neuroandriyanov/PropValve-RE06MT/корпус/README.en.md

# Enclosure and blanking part

[Русский](README.md) | English

RUICHI A09 enclosure

Image of the **RUICHI A09** enclosure supplied by the author. The ribbed lid, screw fastening and mounting lugs are visible. The photograph was copied from the original directory without changes.

| File | Contents |
| --- | --- |
| `RUICHI A09.jpg` | Enclosure appearance |
| `заглушка.m3d` | Original blanking-part model |
| `заглушка.stl` | STL blanking-part model |
| `d.lxcf` | Accompanying file from the original package |

The board is located away from the valve's heat. According to the author's message of 31 October 2026, it operates on the machine, has passed testing, and no board heating has been observed.

## Photographs of the installed unit

- [Control enclosure installed on the machine](../фото/Корпус_на_машине.jpg).
- [Control board inside the enclosure, lid open](../фото/Плата_в_корпусе.jpg).

The author added these photographs on 2 November 2026, and their bytes were preserved. The open-enclosure photograph shows the board layout and connected wires. Enclosure dimensions and ingress-protection rating were not determined from photographs.
