neuroandriyanov/PropValve-RE06MT/схема_плата/README.md

# Аппаратная часть

[Русский](README.md) | [English](README.en.md)

- `схема.pdf` — два листа: питание, силовой/аналоговый тракт; затем DSP, EEPROM и интерфейс.
- `Proportional Valve Controller_v0/` — распакованный набор Gerber/сверловки: 7 файлов `.gbr`, `Through1.drl` и `Through2.tap`.
- `Спецификация_для_пайк.xlsx` — историческая ведомость пайки, номиналы и оценки стоимости. Это не актуальная смета закупки.

Файлы DipTrace `.dip`/`.dch`, библиотеки и ZIP-дубликат Gerber исключены автором из пакета. Для просмотра оставшихся материалов нужны PDF- и Gerber-просмотрщики.

Плата автора уже установлена на машине и прошла испытания; нагрев платы при работе не наблюдается. Следующие замечания относятся к воспроизведению по приложенным материалам.

## Разъёмы данной платы по PDF

| Разъём | Назначение | Примечание |
| --- | --- | --- |
| X1 | Питание 24 В | Контакт 1: +24 В, контакт 2: GND |
| X2 | Катушка | Подключение силового выхода проверять по схеме и своей нагрузке |
| X3 | Выход контроля фактического тока | Контакт 1: сигнал, контакт 2: GND_ISO |
| X4 | Внешнее задание 0–10 В | Контакт 1: сигнал, контакт 2: GND_ISO |
| X5 | Интерфейс программирования | Сверить обе стороны подключения по второму листу схемы |

`GND` и `GND_ISO` — разные обозначенные цепи. Нумерация X1…X5 относится к этой PCB; она не совпадает с обозначениями A…G штатного разъёма Parker. Прямой кабель-переходник и его распиновка в материалах не подтверждены.

## Что учесть при воспроизведении

Для приложенных калибровок **R42 и R43 = 10 кОм**. PDF уже обновлён, но BOM содержит 180 Ом и фото отражает старые номиналы. R3 в той же строке спецификации остаётся отдельным элементом: указание замены относится только к R42/R43.

У DA7.2 в PDF сохранена авторская пометка «ошибка». Фото показывает проводную доработку возле DA7. При воспроизведении следует учитывать эту доработку. PDF и Gerber оставлены без редактирования; отдельного исправленного набора производственных файлов в ходе подготовки пакета не создавалось.

В [папке корпуса](../корпус/README.md) сохранены `заглушка.m3d`, `заглушка.stl`, `d.lxcf` и добавленное автором изображение `RUICHI A09.jpg`.
