neuroandriyanov/PropValve-RE06MT/docs/ENGLISH-UPDATE.md

# English documentation update — 7 November 2026

Package revision 5 adds English companions for the complete authored documentation, the three historical calibration reports, the multimeter protocol guide and the historical handoff. Root and current-directory Markdown documents receive language navigation; Russian technical prose is retained. The Mermaid block diagram has an English version in README.en.md. Shared photographs, all DSP projects, coefficient tables, JSON/JSONL measurements, hardware files, manufacturer PDF and original historical TXT files remain byte-identical.

The schematic's two Russian annotations are translated in `схема_плата/ANNOTATIONS.en.md`. The [English BOM workbook](../схема_плата/Спецификация_для_пайк.en.xlsx) translates 196 text cells across all three worksheets, sheet names, and printed headers and footers. All 416 numerical cells (including formula caches), 238 formulas, component designators, source links, formatting and print settings are preserved; formula and named-range references are updated to the English sheet names. The original XLSX remains byte-identical. Every translated cell label and explanatory note is also documented with its original cell address in `схема_плата/BOM-labels.en.md`. Manufacturer documentation is already English. Hardware connections and ratings are not inferred from labels or photographs.

The workbook was edited and recalculated with the spreadsheet authoring tool. Its export did not preserve existing print settings, so the translated text was transferred into the original XLSX package with only text and sheet-reference substitutions. Unaffected ZIP members were checked byte-for-byte; all three translated sheets were rendered and reviewed, and formula-error scans returned no matches.

The exact previous package manifest is retained at `docs/manifests/pre-english-2026-11-07.json`. Before refreshing the current manifest, its tracked-file hashes were compared: only deliberate Markdown language-navigation edits were permitted. Added translation material and workflow files are included in revision 5. Historical measurement data are not regenerated. The old manifest remains a record of revision 4 and is not updated to make its files appear unchanged.

`translations.json` records hashes of both source and reviewed translation. `tools/translations.mjs status` reports missing or stale translations without preventing Russian-first publication; `status --strict` can be used when checking a completed translation set. Workflow instructions are in `docs/TRANSLATIONS.md` and `docs/TRANSLATIONS.en.md`.

Verification for this update concerns translation links, numerical transcription, package integrity and saved DSP tables. It is not a new compilation, EEPROM write, or hardware test.
