neuroandriyanov/PropValve-RE06MT/проект_сигма/Калибровка_входа_0_10В_2026-10-27.en.md

# 0–10 V input calibration, ADC0 — 27 October 2026

[Русский, original TXT](Калибровка_входа_0_10В_2026-10-27.txt) | English

Historical report translated without changing its values. This temporary X3–X4 calibration connection must not be retained in the final control path; see the [current setup instructions](../docs/SETUP.en.md).

The user fitted an X3–X4 jumper and replaced R42 with 10 kΩ. Calibration used the connected multimeter in DC V mode. The source was the previously calibrated X3 output; measurements were made directly at the connected X3/X4. Eleven points were checked, including intermediate points and a repeated zero.

Working project: `Design1_parker_v0.dspproj`. Complete reference copy: `Design1_parker_io_calibrated.dspproj`. The project was loaded into RAM; EEPROM was not written.

## Input path

`Input1, ADC0 -> VIN_LPF_20Hz -> VIN_TABLE_0_10V -> VIN_LIMIT_MIN -> VIN_LIMIT_MAX -> VIN_MEAS_0_1`.

LPF: first order, 20 Hz, gain 0 dB. At Fs=96 kHz, the time constant is approximately 8 ms; settling to 1% after a step takes approximately 37 ms. `VIN_MEAS_0_1` is the normalized input: voltage in volts = reading * 10. `ADC0_RAW` is unsmoothed ADC0; `VIN_FILTERED` is smoothed ADC0 before normalization. The coil had a zero command during calibration. No connection from `VIN_MEAS_0_1` to the current command was added.

Table Min=-1, Max=+1. This is the ADC0 data range, not the voltage at X4. Over the working 0..10 V range, ADC0 varied approximately -0.02050..+0.74948. No saturation was found. The full table range was retained for margin; its output is separately limited to 0..1 by two conditional blocks. `VIN_ZERO=0`, `VIN_ONE=1`, `VIN_LIMIT_MIN` condition: `>`, `VIN_LIMIT_MAX`: `<`. Negative and greater-than-1 coefficients at the outer table knots are extrapolation and are valid. The final signal is limited to 0..1.

## Coefficients at ADC0 knots -1; -0.5; 0; +0.5; +1

```text
-1.00 -> -1.279143881855
-0.50 -> -0.626184519830
0.00 -> 0.026774842194
0.50 -> 0.676254106065
1.00 -> 1.325107241990
```

## Last independent verification

| Multimeter, V | DSP normalized | Equivalent, V | Difference, mV |
| --- | --- | --- | --- |
| 0.0000 | 0.00000536 | 0.00005 | +0.054 |
| 1.0000 | 0.10006195 | 1.00062 | +0.620 |
| 1.2490 | 0.12503260 | 1.25033 | +1.326 |
| 2.5000 | 0.24994069 | 2.49941 | -0.593 |
| 3.7500 | 0.37491131 | 3.74911 | -0.887 |
| 4.9990 | 0.49981421 | 4.99814 | -0.858 |
| 6.2500 | 0.62501651 | 6.25017 | +0.165 |
| 7.5000 | 0.75012231 | 7.50122 | +1.223 |
| 8.7500 | 0.87510180 | 8.75102 | +1.018 |
| 10.0000 | 0.99988711 | 9.99887 | -1.129 |
| 0.0000 | 0.00000954 | 0.00010 | +0.095 |

Maximum observed difference from the multimeter reading: 1.326 mV. This is a difference between readings in this series, not an estimate of the entire system's absolute error: it also depends on the multimeter's accuracy and resolution.

The earlier 0..10 V output, 0..3 A command and current-measurement tables were compared with the backup before work: their coefficients and ranges were unchanged. The voltage output and current command were returned to zero at the end.

## Files

- `voltage_input_0_10V.txt` — coefficients for loading the table.
- `voltage_input_settings.json` — range, filter, limits and other settings.
- Historical `output/meter/voltage_input_raw.json` — initial ADC0 check.
- Historical `output/meter/voltage_input_filtered.json` — calibration points after the LPF.
- Historical `output/meter/voltage_input_verify.json` — independent normalized-input verification.

The historical `output/meter/` records are now in `measurements/2026-10-27/`.

Before future batch DSP reads, disable continuous controls (Action → Disable All Continuous ReadBack Controls, Ctrl+F12). After API compilation, bind new readbacks using the native Action → Link Compile Download (F7), then Ctrl+F11. Do not rerun the one-off build/connect/fit_voltage_input.py scripts.
