neuroandriyanov/PropValve-RE06MT/проект_сигма/Калибровка_тока_2026-10-27.en.md

# Current and feedback calibration — 27 October 2026

[Русский, original TXT](Калибровка_тока_2026-10-27.txt) | English

Historical report translated without changing its values. Manual sources mentioned here were removed later; see the [current status](../docs/STATUS.en.md).

The user replaced R43: 180 Ω → 10 kΩ. Working project: `Design1_parker_v0.dspproj`. Reference copy: `Design1_parker_current_calibrated.dspproj`. Fs=96 kHz. The project was loaded into RAM. EEPROM was not written.

`CURRENT_INPUT_0_1` is the 0..1 command input in 5.23 format. `CURRENT_0_3A` is the current-command table, input range 0..1. `ZERO_OFF` makes both DAC0/DAC1 digital commands zero for a command <=0. With a positive command, DAC0=table(x), DAC1=-table(x). `ZERO_CONSTANT` must remain zero.

## Measurement path

`ADC1 -> CURRENT_LPF_20Hz -> FB_LIMIT_MIN -> FB_LIMIT_MAX -> I_FEEDBACK_0_1 -> I_MEAS_0_1`.

`CURRENT_LPF_20Hz` is a first-order 20 Hz low-pass filter with 0 dB gain. `I_FEEDBACK_0_1` is a five-point interpolator: Min=-0.78, Max=0.70. `FB_LIMIT_MIN/MAX` explicitly limit the interpolator input to -0.78..0.70. `FB_MIN_CONST=-0.78` and `FB_MAX_CONST=0.70` must match Min/Max.

`I_MEAS_0_1` is normalized measured current; amperes = value * 3. `ADC1_RAW` is the unsmoothed diagnostic ADC1 signal. No digital regulation loop was closed through `I_MEAS_0_1`; the TL494 analog current controller continued to control the power stage.

## Command coefficients

```text
0.00 -> 0.023218750000
0.25 -> 0.159650674870
0.50 -> 0.290056819700
0.75 -> 0.418537411283
1.00 -> 0.546914277550
```

## Measurement coefficients at evenly spaced knots from -0.78 to +0.70

```text
-0.780 -> 0.000000000000
-0.410 -> 0.245772526859
-0.040 -> 0.493489060467
0.330 -> 0.742258512976
0.700 -> 1.000000000000
```

## Independent multimeter verification

| Input | Target, A | Multimeter, A | DSP normalized | DSP equivalent, A |
| --- | --- | --- | --- | --- |
| 0.000 | 0.000 | 0.0000 | 0.000940 | 0.0028 |
| 0.125 | 0.375 | 0.3675 | 0.123211 | 0.3696 |
| 0.250 | 0.750 | 0.7475 | 0.249255 | 0.7478 |
| 0.500 | 1.500 | 1.4995 | 0.499490 | 1.4985 |
| 0.750 | 2.250 | 2.2510 | 0.750680 | 2.2520 |
| 1.000 | 3.000 | 2.9980 | 0.999998 | 3.0000 |
| 0.000 | 0.000 | 0.0000 | 0.000000 | 0.0000 |

After R43 was replaced, no ADC1 saturation was found over 0..3 A: at approximately 3 A, the unsmoothed signal was approximately +0.658 to +0.754. Smoothing reduces reading spread but does not eliminate zero drift. In one calibration series, zero shifted by approximately 0.013 ADC units, equivalent to approximately 26 mA. A fixed table does not compensate for zero changes between series.

This verification describes the board during the measurements, not guaranteed temperature accuracy after cooling/warming. The interpolator itself does not correctly limit values outside Min/Max: before `FB_LIMIT_MIN/MAX` were added, that caused incorrect readings at the ends. Separate blocks now limit the input before the interpolator. Apply `CURRENT_INPUT_0_1` only within its stated 0..1 range.

Full records: historical path `output/meter/feedback_*.json` (now under `measurements/2026-10-27/`). `current_command_0_3A.txt` and `current_feedback_0_3A.txt` contain coefficients only. Min/Max are saved in the project and JSON. DAC3 0..10 V voltage calibration was checked; coefficients were unchanged. At the end, the command was set to zero. Do not rerun the one-off `install_*.py` and `refine_feedback.py` scripts.
