neuroandriyanov/PropValve-RE06MT/корпус/README.md

# Корпус и заглушка

[Русский](README.md) | [English](README.en.md)

Корпус RUICHI A09

Изображение корпуса **RUICHI A09**, добавленное автором. Видны ребристая крышка, винтовое крепление и монтажные проушины. Фото скопировано из исходной папки без изменений.

| Файл | Содержимое |
| --- | --- |
| `RUICHI A09.jpg` | Внешний вид корпуса |
| `заглушка.m3d` | Исходная модель заглушки |
| `заглушка.stl` | STL-модель заглушки |
| `d.lxcf` | Сопутствующий файл исходного комплекта |

Плата вынесена из зоны нагрева клапана. По сообщению автора от 31.10.2026 она работает на машине, прошла испытания, нагрев платы не наблюдается.

## Фотографии установленного блока

- [Корпус блока управления, установленный на машине](../фото/Корпус_на_машине.jpg).
- [Плата управления в корпусе — вид при открытой крышке](../фото/Плата_в_корпусе.jpg).

Фотографии добавлены автором 02.11.2026 и сохранены без изменения байтов. На снимке открытого корпуса видны размещение платы и подключённые провода. Размеры и степень защиты корпуса по фотографиям не определялись.
