neuroandriyanov/PropValve-RE06MT/docs/STATUS.md

# Состояние проекта и результаты проверки материалов

[Русский](STATUS.md) | [English](STATUS.en.md)

Состояние сохранённых калибровок: 27.10.2026. Уточнение автора и повторный обзор пакета: 31.10.2026.

## Работа на машине

Автор сообщил 31.10.2026: **плата уже установлена и работает на машине, испытания пройдены, нагрев платы не наблюдается**. Вынос электроники из зоны нагрева клапана выполнен и проверен в эксплуатации данного экземпляра.

Прежняя запись о том, что объединённая цепь ещё не испытана, описывала состояние журнала калибровки от 27.10.2026. Для текущего эксплуатационного статуса она устарела. Указанная дата — дата сообщения автора, а не установленная дата проведения испытаний. Численные температуры, длительность и режимы испытаний не сообщались.

## Рабочая версия

`проект_сигма/Design1_parker_v0.dspproj` и `Design1_parker_transfer_2026-10-27.dspproj` побайтово совпали при подготовке. Файл разобран data-only NRBF-парсером: в нём четыре таблицы, нужные константы и индикаторы; старых ручных источников `CURRENT_INPUT_0_1` и `DC2_4` нет. Соединения сохранённого netlist соответствуют цепям, приведённым в README.

Отчёт сохранённого компилятора: 153 инструкции, 38 слов Data RAM, 45 слов Parameter RAM. Сам отчёт содержит общий текст об оценке для 48 кГц; используемая частота проекта 96 кГц зафиксирована в настройках калибровки и журнале. Не трактуйте строку шаблона отчёта как подтверждение текущей частоты аппаратуры.

При подготовке документов ассистент проверяет файлы без подключения к оборудованию. Испытания на машине проведены автором; повторный запуск машины в рамках обзора папки не выполнялся. Рабочий `.dspproj` в пакете не изменялся.

## Калибровки

Ниже — максимальные наблюдавшиеся разности в сохранённых сериях, а не гарантированная абсолютная точность или допуск для другого экземпляра платы.

| Канал | Наблюдение | Протокол в `measurements/2026-10-27/` |
| --- | --- | --- |
| Выход 0–10 В | До 1 мВ относительно показания прибора | `output_calibration_verification.json` |
| Задание тока | До 7.5 мА между заданием и показанием прибора | `feedback_final_verification.json` |
| Измерение тока DSP | Около 2.8 мА относительно прибора в итоговой серии | `feedback_final_verification.json` |
| Вход 0–10 В | До 1.326 мВ, проверка в 11 точках | `voltage_input_verify.json` |

Эти сохранённые серии относятся к калибровке отдельных каналов **до окончательного объединения цепи**. После этого автор подтвердил успешные испытания платы на машине. Точность приведённых серий ограничивается в том числе точностью и разрешением мультиметра. В одной старой серии отмечен дрейф нуля измерения тока примерно на 26 мА в эквиваленте. Это наблюдение калибровочного этапа, а не результат нового измерения на машине.

Точные коэффициенты и Min/Max извлекаются командой `py -3 tools/sigma/inspect_project.py`. Внешние TXT-файлы коэффициентов не содержат всей настройки блока. Сохранённый `.dspproj` и JSON-настройки предпочтительнее для восстановления.

| Таблица | Входной диапазон | Роль |
| --- | --- | --- |
| `VIN_TABLE_0_10V` | −1…+1 | ADC0 → нормированное напряжение; выход дополнительно ограничен 0…1 |
| `CURRENT_0_3A` | 0…1 | Задание → код дифференциального выхода DAC0/DAC1 |
| `I_FEEDBACK_0_1` | −0.78…+0.70 | ADC1 → нормированный фактический ток; перед таблицей стоят ограничители |
| `Interpolator1` | 0…1 | Нормированный ток → DAC3 → X3; DAC2 должен быть 0 |

## Различия между материалами

1. **R42/R43.** В текущем PDF уже 10 кОм. В исходной спецификации XLSX — 180 Ом, на фото видна маркировка `1800`. Рабочие калибровки относятся к 10 кОм. Фото и BOM оставлены без правок как исходные материалы; их нельзя безусловно использовать для сборки откалиброванной версии.
2. **DA7.2.** На первом листе схемы есть пометка «ошибка» у буфера refdac. Возле DA7 на фото видна проводная доработка. Документированного соответствия этой доработки конкретной PCB-ревизии нет. Схему исправления по одному фото не восстанавливали.
3. **Состав аппаратных файлов.** По решению автора `.dip`, `.dch`, библиотеки DipTrace и ZIP-дубликат удалены из пакета. Сохранены PDF, распакованный набор Gerber/сверловки v0 и XLSX. Для нового изготовления учитывайте номиналы и доработку, описанные выше.
4. **Распиновка и диапазоны.** Маркировка платы на фото упоминает ±10 В; сохранённый DSP-проект откалиброван на 0…10 В. Не расширяйте рабочий диапазон только по надписи на PCB.
5. **Паспорт Parker.** В приложенном документе есть исполнения F (0…10 В в таблице и блок-схеме) и R (4…20 мА). На вводной странице также встречается ±10 В. Это не подтверждает поддержку всех вариантов данной платой. Точный заказной код модернизированного экземпляра отсутствует.
6. **Ток.** В паспорте штатного клапана указан максимальный потребляемый ток 2.0 А. Это не равно утверждённому пределу тока катушки. Шкала стендовой платы 3 А требует отдельного сопоставления с конкретным соленоидом; универсальная совместимость не установлена.
7. **EEPROM.** E2Prom.bin/Hex в `archive/eeprom-unverified/` относятся к исходному архиву. Журнал от 27.10.2026 отмечал отсутствие записи на том этапе. Сведения о текущем содержимом EEPROM работающей машины отдельно не передавались; архивные образы не объявляются её проверенной копией.

## Воспроизведение на другом экземпляре

Для нового экземпляра уточняют исполнение клапана и параметры катушки, сверяют PDF/BOM/Gerber и доработку DA7.2, затем проводят собственную калибровку. Порядок подключения и проверки перемычки X3–X4 приведён в [SETUP.md](SETUP.md). Это порядок переноса на другое оборудование, а не перечень непроведённых испытаний авторской машины.

В сохранённом DSP-проекте `ZERO_OFF` сравнивает задание с точным нулём. Обсуждавшийся ранее гистерезис 10/20 мВ в этом файле не реализован. Это возможное развитие проекта, а не установленный недостаток работы машины. `ZERO_CONSTANT` питает и порог, и нулевой выход; изменять его без разделения этих функций нельзя.

## Корпус и обновление комплекта

Добавлено [изображение RUICHI A09](../корпус/RUICHI%20A09.jpg), найденное в исходной папке `корпус/`. Оно показывает внешний вид корпуса с ребристой крышкой и монтажными проушинами. Файлы заглушки сохранены, состав описан в [корпус/README.md](../корпус/README.md).

02.11.2026 автор добавил фотографии [корпуса блока управления на машине](../фото/Корпус_на_машине.jpg) и [платы управления в открытом корпусе](../фото/Плата_в_корпусе.jpg). Обе фотографии включены в README и сохранены без изменения байтов. Это дата добавления материалов, а не установленная дата съёмки или новых испытаний.
