neuroandriyanov/PropValve-RE06MT/archive/README.md

# Исторические материалы

[Русский](README.md) | [English](README.en.md)

`НАЧАТЬ_ЗДЕСЬ_ПЕРЕНОС_ПРОЕКТА.txt` сохранён без изменений. Это описание исходной рабочей папки от 27.10.2026. Пути `output/meter` в нём соответствуют нынешнему `measurements/2026-10-27`, а актуальные инструкции — `docs/SETUP.md` и `AGENTS.md`. Уточнения к схеме и фото находятся в `docs/STATUS.md`.

Статус ожидающих испытаний из старого журнала устарел: 31.10.2026 автор подтвердил, что плата работает на машине, испытания пройдены, нагрев платы не наблюдается. Упоминания DipTrace и библиотек также относятся к исходной папке — автор исключил их из текущего пакета.

`legacy-tools/` содержит исходные Python/C#/PowerShell-файлы старого набора. Они помещены в архив без адаптации и **не являются запускаемым комплектом**: относительные пути после переноса, HWND/PID, адреса параметров, имена блоков и состояние аппаратуры могут не совпадать. Некоторые модули выполняют запись сразу при импорте. Изучайте код как историю; адаптируйте нужную операцию отдельно. Рабочие переносимые помощники находятся в корневом `tools/`.

`eeprom-unverified/` содержит оригинальные `E2Prom.bin` и `E2Prom.Hex`. Их соответствие окончательному проекту и фактической EEPROM не установлено. Готовой проверенной прошивкой они не объявляются.
