neuroandriyanov/PropValve-RE06MT/фото/PCB_BOTTOM.JPG

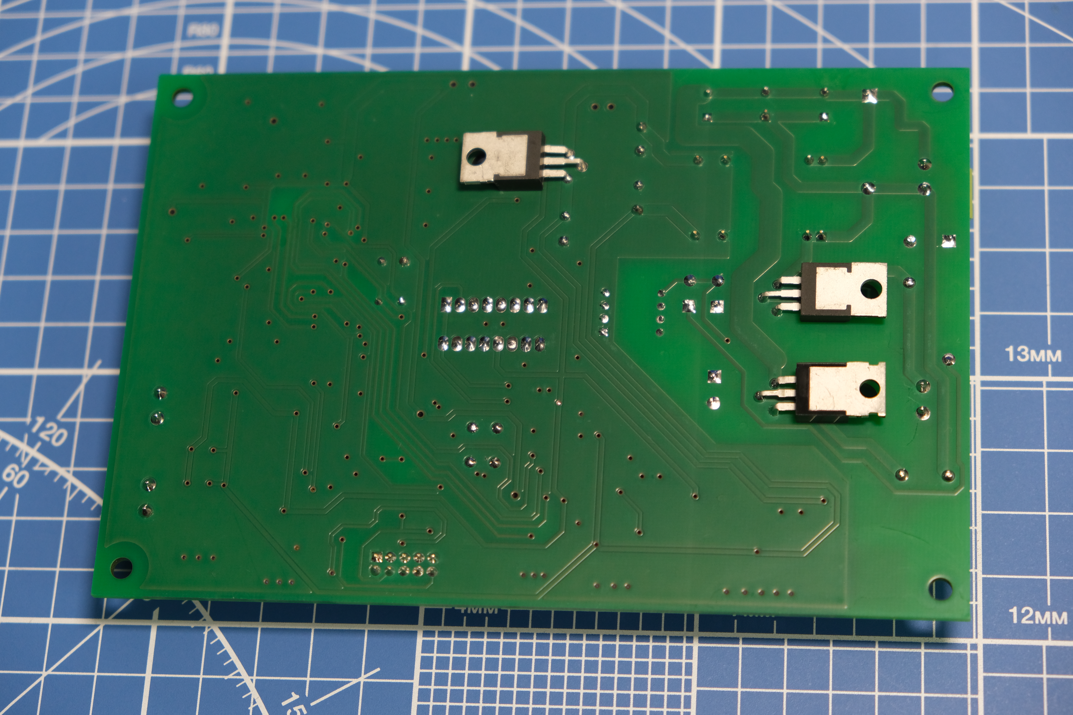
фото/PCB_BOTTOM.JPG
