neuroandriyanov/PropValve-RE06MT/схема_плата/Спецификация_для_пайк.en.xlsx

Sheet: Soldering order
Packet no. | Reference designators | Value | Type | Quantity | Unit price, RUB | Cost, RUB | Soldered
1. 0805 resistors and capacitors
1 | C54 | 3.3nF 25V | CAP_0805 | 1 | 15.00 | 15.00
2 | C50 | 56nF 25V | CAP_0805 | 1 | 15.00 | 15.00
3 | C34, C35, C36, C38, C40, C43, C53, C57, C62, C63, C65, C66, C69, C70, C94, C97 | 0.1uF 25V | CAP_0805 | 16 | 9.26 | 148.16
4 | C39, C44, C46, C58, C64 | 10uF 25V | CAP_0805 | 5 | 17.68 | 88.40
5 | R57 | 51 | RES_0805 | 1 | 8.42 | 8.42
6 | R48 | 475 | RES_0805 | 1 | 8.42 | 8.42
7 | R44 | 1K | RES_0805 | 1 | 8.42 | 8.42
8 | R68, R69, R71, R72 | 2.2K | RES_0805 | 4 | 8.42 | 33.68
9 | R46, R47, R49, R51, R53, R54, R59 | 10K | RES_0805 | 7 | 8.42 | 58.94
10 | R45 | 18K | RES_0805 | 1 | 8.42 | 8.42
11 | R60 | 100K | RES_0805 | 1 | 8.42 | 8.42
2. Small diodes and transistors
12 | D13, D14 | BAS70W-04 | BAS70W-04 | 2 | 29.47 | 58.94
13 | D10, D11, D16, D17 |  | BAV99 | 4 | 17.68 | 70.72
14 | VT1 | FMMT717TA | FMMT717TA | 1 | 69.04 | 69.04
3. 1206 resistors and capacitors
15 | C13, C17 | 0.01uF 25v | CAP_1206 | 2 | 15.00 | 30.00
16 | C16 | 0.03uF 25v | CAP_1206 | 1 | 20.00 | 20.00
17 | C9, C12, C14, C15, C18, C19, C20, C21, C22, C23, C25 | 0.1uF 25v | CAP_1206 | 11 | 15.00 | 165.00
18 | C52 | 47uF 25V | CAP_1206 | 1 | 82.51 | 82.51
19 | R4 | 10 | RES1206 | 1 | 8.42 | 8.42
20 | R3, R42, R43 | 180 | RES1206 | 3 | 8.42 | 25.26
21 | R6, R9, R10, R15, R16, R17, R18, R19, R20, R21, R22, R30, R32, R34, R35 | 1K | RES1206 | 15 | 8.42 | 126.30
22 | R24, R25 | 2K | RES1206 | 2 | 8.42 | 16.84
23 | R8, R11, R26, R28, R38, R39, R40, R41 | 10K | RES1206 | 8 | 8.42 | 67.36
24 | R36 | 14K | RES1206 | 1 | 8.42 | 8.42
25 | R13, R27, R29 | 20K | RES1206 | 3 | 8.42 | 25.26
26 | R31, R33 | 25K | RES1206 | 2 | 8.42 | 16.84
27 | R1, R2, R23 | 30K | RES1206 | 3 | 8.42 | 25.26
28 | R7, R12 | 51K | RES1206 | 2 | 8.42 | 16.84
29 | R14, R37 | 100K | RES1206 | 2 | 8.42 | 16.84
4. 1210 capacitors
30 | C4, C6, C8, C11, C24 | 10uF 50v | CAP1210 | 5 | 58.10 | 290.50
5. ICs and oscillator
31 | DD4 | 24LC512 | 24LC512 | 1 | 154.08 | 154.08
32 | DD3 | 74LVC1G125GV | 74LVC1G125GV | 1 | 30.00 | 30.00
33 | DA1 | ACS712 | ACS712 | 1 | 336.79 | 336.79
34 | DD1 | ADAU1701JSTZ | ADAU1701JSTZ | 1 | 1243.60 | 1243.60
35 | DD5 | ADM811R | ADM811R | 1 | 178.50 | 178.50
36 | OSC1 | ASFL1-12.288MHZ | ASFL1-12.288MHZ | 1 | 184.39 | 184.39
37 | DD2 | ISO1540DR | ISO1540DR | 1 | 394.04 | 394.04
38 | DA9 | LDL1117S33R | LDL1117S33R | 1 | 34.52 | 34.52
39 | DA4, DA5, DA6, DA7, DA8 |  | OP2177 | 5 | 556.55 | 2782.75
40 | DA3 |  | TL494 | 1 | 37.89 | 37.89
6. Protection and through-hole diodes
41 | D1 | 1.5KE30A | 1.5KE30A | 1 | 77.46 | 77.46
42 | D4, D5, D8 | 1N4744A | 1N4744A | 3 | 23.58 | 70.74
43 | D2, D3 | SMBJ12A | SMBJ12A | 2 | 41.26 | 82.52
44 | D12 | SMBJ3V3 | SMBJ3V3 | 1 | 63.15 | 63.15
45 | D9, D15 | SMBJ5A / SMBJ5.0 | SMBJ5A / SMBJ5.0 | 2 | 42.10 | 84.20
46 | D6, D7 | SR540 | SR540 | 2 | 35.00 | 70.00
7. Power components and optocoupled driver
47 | R5 | 330 ohm, 2 W | 330 ohm, 2 W | 1 | 25.00 | 25.00
48 | OPT1 | HCPL3120 | HCPL3120 | 1 | 323.32 | 323.32
49 | DA2 | LM2940 | LM2940 | 1 | 168.40 | 168.40
50 | Q2 | STP80NF55 | STP80NF55 | 1 | 63.15 | 63.15
51 | Q1 | STP80PF55 | STP80PF55 | 1 | 606.22 | 606.22
8. Connectors and pushbutton
52 | X1, X2, X3, X4 |  | DG103-02P | 4 | 60.00 | 240.00
53 | X5 |  | IDC10 | 1 | 40.00 | 40.00
54 | SA1 | KLS7-TS6601-4.3-180 | KLS7-TS6601-4.3-180 | 1 | 15.00 | 15.00
55 | J1, J2 |  | SWD1 | 2 | 50.00 | 100.00
9. Electrolytic capacitors and power module
56 | C10 | 220uF 50v | K50-35 | 1 | 70.00 | 70.00
57 | C5, C7 | 680uF 50v | K50-35 | 2 | 120.00 | 240.00
58 | C1, C2, C3 | 1000uF 50v | K50-35 | 3 | 160.00 | 480.00
59 | U1 | TEN 5-2422 | TEN 5-2422 | 1 | 2748.21 | 2748.21
 | Total: components and estimated cost |  |  | 153 |  | 12485.56

Sheet: Source data
Reference designator | Value | Type
C1 | 1000uF 50v | K50-35
C2 | 1000uF 50v | K50-35
C3 | 1000uF 50v | K50-35
C4 | 10uF 50v | CAP1210
C5 | 680uF 50v | K50-35
C6 | 10uF 50v | CAP1210
C7 | 680uF 50v | K50-35
C8 | 10uF 50v | CAP1210
C9 | 0.1uF 25v | CAP_1206
C10 | 220uF 50v | K50-35
C11 | 10uF 50v | CAP1210
C12 | 0.1uF 25v | CAP_1206
C13 | 0.01uF 25v | CAP_1206
C14 | 0.1uF 25v | CAP_1206
C15 | 0.1uF 25v | CAP_1206
C16 | 0.03uF 25v | CAP_1206
C17 | 0.01uF 25v | CAP_1206
C18 | 0.1uF 25v | CAP_1206
C19 | 0.1uF 25v | CAP_1206
C20 | 0.1uF 25v | CAP_1206
C21 | 0.1uF 25v | CAP_1206
C22 | 0.1uF 25v | CAP_1206
C23 | 0.1uF 25v | CAP_1206
C24 | 10uF 50v | CAP1210
C25 | 0.1uF 25v | CAP_1206
C34 | 0.1uF 25V | CAP_0805
C35 | 0.1uF 25V | CAP_0805
C36 | 0.1uF 25V | CAP_0805
C38 | 0.1uF 25V | CAP_0805
C39 | 10uF 25V | CAP_0805
C40 | 0.1uF 25V | CAP_0805
C43 | 0.1uF 25V | CAP_0805
C44 | 10uF 25V | CAP_0805
C46 | 10uF 25V | CAP_0805
C50 | 56nF 25V | CAP_0805
C52 | 47uF 25V | CAP_1206
C53 | 0.1uF 25V | CAP_0805
C54 | 3.3nF 25V | CAP_0805
C57 | 0.1uF 25V | CAP_0805
C58 | 10uF 25V | CAP_0805
C62 | 0.1uF 25V | CAP_0805
C63 | 0.1uF 25V | CAP_0805
C64 | 10uF 25V | CAP_0805
C65 | 0.1uF 25V | CAP_0805
C66 | 0.1uF 25V | CAP_0805
C69 | 0.1uF 25V | CAP_0805
C70 | 0.1uF 25V | CAP_0805
C94 | 0.1uF 25V | CAP_0805
C97 | 0.1uF 25V | CAP_0805
D1 | 1.5KE30A | 1.5KE30A
D2 | SMBJ12A | SMBJ12A
D3 | SMBJ12A | SMBJ12A
D4 | 1N4744A | 1N4744A
D5 | 1N4744A | 1N4744A
D6 | SR540 | SR540
D7 | SR540 | SR540
D8 | 1N4744A | 1N4744A
D9 | SMBJ5A | SMBJ5A
D10 |  | BAV99
D11 |  | BAV99
D12 | SMBJ3V3 | SMBJ3V3
D13 | BAS70W-04 | BAS70W-04
D14 | BAS70W-04 | BAS70W-04
D15 | SMBJ5.0 | SMBJ5.0
D16 |  | BAV99
D17 |  | BAV99
DA1 | ACS712 | ACS712
DA2 | LM2940 | LM2940
DA3 |  | TL494
DA4 |  | OP2177
DA5 |  | OP2177
DA6 |  | OP2177
DA7 |  | OP2177
DA8 |  | OP2177
DA9 | LDL1117S33R | LDL1117S33R
DD1 | ADAU1701JSTZ | ADAU1701JSTZ
DD2 | ISO1540DR | ISO1540DR
DD3 | 74LVC1G125GV | 74LVC1G125GV
DD4 | 24LC512 | 24LC512
DD5 | ADM811R | ADM811R
J1 |  | SWD1
J2 |  | SWD1
OPT1 | HCPL3120 | HCPL3120
OSC1 | ASFL1-12.288MHZ | ASFL1-12.288MHZ
Q1 | STP80PF55 | STP80PF55
Q2 | STP80NF55 | STP80NF55
R1 | 30K | RES1206
R2 | 30K | RES1206
R3 | 180 | RES1206
R4 | 10 | RES1206
R5 | 330 ohm, 2 W | 330 ohm, 2 W
R6 | 1K | RES1206
R7 | 51K | RES1206
R8 | 10K | RES1206
R9 | 1K | RES1206
R10 | 1K | RES1206
R11 | 10K | RES1206
R12 | 51K | RES1206
R13 | 20K | RES1206
R14 | 100K | RES1206
R15 | 1K | RES1206
R16 | 1K | RES1206
R17 | 1K | RES1206
R18 | 1K | RES1206
R19 | 1K | RES1206
R20 | 1K | RES1206
R21 | 1K | RES1206
R22 | 1K | RES1206
R23 | 30K | RES1206
R24 | 2K | RES1206
R25 | 2K | RES1206
R26 | 10K | RES1206
R27 | 20K | RES1206
R28 | 10K | RES1206
R29 | 20K | RES1206
R30 | 1K | RES1206
R31 | 25K | RES1206
R32 | 1K | RES1206
R33 | 25K | RES1206
R34 | 1K | RES1206
R35 | 1K | RES1206
R36 | 14K | RES1206
R37 | 100K | RES1206
R38 | 10K | RES1206
R39 | 10K | RES1206
R40 | 10K | RES1206
R41 | 10K | RES1206
R42 | 180 | RES1206
R43 | 180 | RES1206
R44 | 1K | RES_0805
R45 | 18K | RES_0805
R46 | 10K | RES_0805
R47 | 10K | RES_0805
R48 | 475 | RES_0805
R49 | 10K | RES_0805
R51 | 10K | RES_0805
R53 | 10K | RES_0805
R54 | 10K | RES_0805
R57 | 51 | RES_0805
R59 | 10K | RES_0805
R60 | 100K | RES_0805
R68 | 2.2K | RES_0805
R69 | 2.2K | RES_0805
R71 | 2.2K | RES_0805
R72 | 2.2K | RES_0805
SA1 | KLS7-TS6601-4.3-180 | KLS7-TS6601-4.3-180
U1 | TEN 5-2422 | TEN 5-2422
VT1 | FMMT717TA | FMMT717TA
X1 |  | DG103-02P
X2 |  | DG103-02P
X3 |  | DG103-02P
X4 |  | DG103-02P
X5 |  | IDC10

Sheet: Prices and sources
Estimated component prices
Checked on 20 September 2026. Prices per unit; excluding shipping, taxes, duties and intermediary markups.
USD → RUB | 84.1975 | Central Bank exchange rate effective 19 September 2026: https://www.cbr.ru/currency_base/daily/
Catalogue: a located price for the selected variant. Estimate: an assumption. Series estimate: a price for a similar value in the series.
Variants were selected only to estimate cost; reference designators, values and types in the BOM were not replaced.
Packet no. | Product used for estimate | Source price | Currency | Unit price, RUB | Basis | Explanation | Source
1 | Exact part number not selected | 15.00 | RUB | 15.00 | Estimate | Estimate for 3.3 nF / 25 V / 0805; dielectric and tolerance unspecified. | Retailer price not confirmed
2 | Exact part number not selected | 15.00 | RUB | 15.00 | Estimate | Estimate for 56 nF / 25 V / 0805; dielectric and tolerance unspecified. | Retailer price not confirmed
3 | CL21B104KACNNNC | 0.11 | USD | 9.26 | Catalogue | 100 nF, 25 V, 0805, X7R, ±10%; example variant for estimating cost. | https://www.digikey.com/en/products/detail/samsung-electro-mechanics/CL21B104KACNNNC/3886757
4 | CL21A106KAYNNNE | 0.21 | USD | 17.68 | Catalogue | 10 µF, 25 V, 0805, X5R; example variant. Listed as unavailable on the page. | https://www.digikey.com/en/products/detail/samsung-electro-mechanics/CL21A106KAYNNNE/3888549
5 | RC0805FR-071KL (1 kΩ) | 0.10 | USD | 8.42 | Series estimate | Reference based on a 1 kΩ 0805 resistor; price for the exact value 51 not confirmed. | https://www.digikey.com/en/products/detail/yageo/RC0805FR-071KL/727444
6 | RC0805FR-071KL (1 kΩ) | 0.10 | USD | 8.42 | Series estimate | Reference based on a 1 kΩ 0805 resistor; price for the exact value 475 not confirmed. | https://www.digikey.com/en/products/detail/yageo/RC0805FR-071KL/727444
7 | RC0805FR-071KL (1 kΩ) | 0.10 | USD | 8.42 | Catalogue | Price per unit; quantity discounts not applied. | https://www.digikey.com/en/products/detail/yageo/RC0805FR-071KL/727444
8 | RC0805FR-071KL (1 kΩ) | 0.10 | USD | 8.42 | Series estimate | Reference based on a 1 kΩ 0805 resistor; price for the exact value 2.2K not confirmed. | https://www.digikey.com/en/products/detail/yageo/RC0805FR-071KL/727444
9 | RC0805FR-071KL (1 kΩ) | 0.10 | USD | 8.42 | Series estimate | Reference based on a 1 kΩ 0805 resistor; price for the exact value 10K not confirmed. | https://www.digikey.com/en/products/detail/yageo/RC0805FR-071KL/727444
10 | RC0805FR-071KL (1 kΩ) | 0.10 | USD | 8.42 | Series estimate | Reference based on a 1 kΩ 0805 resistor; price for the exact value 18K not confirmed. | https://www.digikey.com/en/products/detail/yageo/RC0805FR-071KL/727444
11 | RC0805FR-071KL (1 kΩ) | 0.10 | USD | 8.42 | Series estimate | Reference based on a 1 kΩ 0805 resistor; price for the exact value 100K not confirmed. | https://www.digikey.com/en/products/detail/yageo/RC0805FR-071KL/727444
12 | BAS70W-04-7-F | 0.35 | USD | 29.47 | Catalogue | Listed as unavailable on the page; backorder price. | https://www.digikey.com/en/products/detail/diodes-incorporated/BAS70W-04-7-F/815026
13 | BAV99, SMC Diode Solutions | 0.21 | USD | 17.68 | Catalogue | Manufacturer unspecified in the source; example BAV99 price. | https://www.digikey.com/en/products/detail/smc-diode-solutions/BAV99/6022507
14 | FMMT717TA | 0.82 | USD | 69.04 | Catalogue |  | https://www.digikey.com/en/products/detail/diodes-incorporated/FMMT717TA/243276
15 | Exact part number not selected | 15.00 | RUB | 15.00 | Estimate | Estimate for 0.01 µF / 25 V / 1206; dielectric and tolerance unspecified. | Retailer price not confirmed
16 | Exact part number not selected | 20.00 | RUB | 20.00 | Estimate | Estimate for 0.03 µF / 25 V / 1206. The 0.03 value is retained, not replaced with 0.033. | Retailer price not confirmed
17 | Exact part number not selected | 15.00 | RUB | 15.00 | Estimate | Estimate for 0.1 µF / 25 V / 1206; dielectric and tolerance unspecified. | Retailer price not confirmed
18 | C3216X5R1E476M160AC | 0.98 | USD | 82.51 | Catalogue | 47 µF, 25 V, 1206, X5R; example variant. Listed as unavailable on the page. | https://www.digikey.com/en/products/detail/tdk/C3216X5R1E476M160AC/2792260
19 | RC1206FR-071KL (1 kΩ) | 0.10 | USD | 8.42 | Series estimate | Reference based on a 1 kΩ 1206 resistor; price for the exact value 10 not confirmed. | https://www.digikey.com/en/products/detail/yageo/RC1206FR-071KL/728387
20 | RC1206FR-071KL (1 kΩ) | 0.10 | USD | 8.42 | Series estimate | Reference based on a 1 kΩ 1206 resistor; price for the exact value 180 not confirmed. | https://www.digikey.com/en/products/detail/yageo/RC1206FR-071KL/728387
21 | RC1206FR-071KL (1 kΩ) | 0.10 | USD | 8.42 | Catalogue | Price per unit; quantity discounts not applied. | https://www.digikey.com/en/products/detail/yageo/RC1206FR-071KL/728387
22 | RC1206FR-071KL (1 kΩ) | 0.10 | USD | 8.42 | Series estimate | Reference based on a 1 kΩ 1206 resistor; price for the exact value 2K not confirmed. | https://www.digikey.com/en/products/detail/yageo/RC1206FR-071KL/728387
23 | RC1206FR-071KL (1 kΩ) | 0.10 | USD | 8.42 | Series estimate | Reference based on a 1 kΩ 1206 resistor; price for the exact value 10K not confirmed. | https://www.digikey.com/en/products/detail/yageo/RC1206FR-071KL/728387
24 | RC1206FR-071KL (1 kΩ) | 0.10 | USD | 8.42 | Series estimate | Reference based on a 1 kΩ 1206 resistor; price for the exact value 14K not confirmed. | https://www.digikey.com/en/products/detail/yageo/RC1206FR-071KL/728387
25 | RC1206FR-071KL (1 kΩ) | 0.10 | USD | 8.42 | Series estimate | Reference based on a 1 kΩ 1206 resistor; price for the exact value 20K not confirmed. | https://www.digikey.com/en/products/detail/yageo/RC1206FR-071KL/728387
26 | RC1206FR-071KL (1 kΩ) | 0.10 | USD | 8.42 | Series estimate | Reference based on a 1 kΩ 1206 resistor; price for the exact value 25K not confirmed. | https://www.digikey.com/en/products/detail/yageo/RC1206FR-071KL/728387
27 | RC1206FR-071KL (1 kΩ) | 0.10 | USD | 8.42 | Series estimate | Reference based on a 1 kΩ 1206 resistor; price for the exact value 30K not confirmed. | https://www.digikey.com/en/products/detail/yageo/RC1206FR-071KL/728387
28 | RC1206FR-071KL (1 kΩ) | 0.10 | USD | 8.42 | Series estimate | Reference based on a 1 kΩ 1206 resistor; price for the exact value 51K not confirmed. | https://www.digikey.com/en/products/detail/yageo/RC1206FR-071KL/728387
29 | RC1206FR-071KL (1 kΩ) | 0.10 | USD | 8.42 | Series estimate | Reference based on a 1 kΩ 1206 resistor; price for the exact value 100K not confirmed. | https://www.digikey.com/en/products/detail/yageo/RC1206FR-071KL/728387
30 | CL32B106KBJNNNE | 0.69 | USD | 58.10 | Catalogue | 10 µF, 50 V, 1210, X7R; example variant. Listed as unavailable on the page. | https://www.digikey.com/en/products/detail/samsung-electro-mechanics/CL32B106KBJNNNE/3889045
31 | 24LC512-I/ST | 1.83 | USD | 154.08 | Catalogue | TSSOP-8 selected for the estimate; 24LC512 package unspecified in the source. | https://www.digikey.com/en/products/detail/microchip-technology/24LC512-I-ST/2201938
32 | Exact part number not selected | 30.00 | RUB | 30.00 | Estimate | Estimated 74LVC1G125GV price; no offer with a confirmed price was found. | Retailer price not confirmed
33 | ACS712ELCTR-05B-T | 4.00 | USD | 336.79 | Catalogue | 5 A variant selected for the estimate; the BOM specifies only ACS712. | https://www.digikey.com/en/products/detail/allegro-microsystems/ACS712ELCTR-05B-T/1284593
34 | ADAU1701JSTZ | 14.77 | USD | 1243.60 | Catalogue |  | https://www.digikey.com/en/products/detail/analog-devices-inc/ADAU1701JSTZ/1246074
35 | ADM811RARTZ-REEL7 | 2.12 | USD | 178.50 | Catalogue | SOT-143-4 variant selected for the estimate. | https://www.digikey.com/en/products/detail/analog-devices-inc/ADM811RARTZ-REEL7/1007315
36 | ASFL1-12.288MHZ-EC-T | 2.19 | USD | 184.39 | Catalogue | EC-T suffix selected for the estimate; full suffix absent from the source. | https://www.digikey.com/en/products/detail/abracon-llc/ASFL1-12-288MHZ-EC-T/687856
37 | ISO1540DR | 4.68 | USD | 394.04 | Catalogue | Listed as unavailable on the page; backorder price. | https://www.digikey.com/en/products/detail/texas-instruments/ISO1540DR/3587222
38 | LDL1117S33R | 0.41 | USD | 34.52 | Catalogue |  | https://www.digikey.com/en/products/detail/stmicroelectronics/LDL1117S33R/7102071
39 | OP2177ARZ | 6.61 | USD | 556.55 | Catalogue | SOIC-8 selected for the estimate; full suffix absent. Listed as unavailable on the page. | https://www.digikey.com/en/products/detail/analog-devices-inc/OP2177ARZ/820332
40 | TL494CDR | 0.45 | USD | 37.89 | Catalogue | SOIC-16 selected for the estimate; package unspecified in the source. | https://www.digikey.com/en/products/detail/texas-instruments/TL494CDR/276936
41 | 1.5KE30A, Littelfuse | 0.92 | USD | 77.46 | Catalogue |  | https://www.digikey.com/en/products/detail/littelfuse-inc/1-5KE30A/285858
42 | 1N4744A, onsemi | 0.28 | USD | 23.58 | Catalogue |  | https://www.digikey.com/en/products/detail/onsemi/1N4744A/977267
43 | SMBJ12A, Littelfuse | 0.49 | USD | 41.26 | Catalogue |  | https://www.digikey.com/en/products/detail/littelfuse-inc/SMBJ12A/285970
44 | SMBJ3V3-E3/5B | 0.75 | USD | 63.15 | Catalogue |  | https://www.digikey.com/en/products/detail/vishay-general-semiconductor-diodes-division/SMBJ3V3-E3-5B/2147834
45 | SMBJ5.0A, Littelfuse | 0.50 | USD | 42.10 | Catalogue | Price for D9 and D15 combined at the user's request. | https://www.digikey.com/en/products/detail/littelfuse-inc/SMBJ5-0A/285950
46 | Exact part number not selected | 35.00 | RUB | 35.00 | Estimate | SR540 estimate; retailer price for the exact part number not confirmed. | Retailer price not confirmed
47 | Exact part number not selected | 25.00 | RUB | 25.00 | Estimate | Estimate for a 330 Ω, 2 W resistor; material and tolerance unspecified. | Retailer price not confirmed
48 | HCPL-3120-000E | 3.84 | USD | 323.32 | Catalogue | DIP-8 selected for the estimate; suffix unspecified in the source. | https://www.digikey.com/en/products/detail/broadcom-limited/HCPL-3120-000E/669903
49 | LM2940CT-5.0/NOPB | 2.00 | USD | 168.40 | Catalogue | 5 V, TO-220 selected for the estimate; voltage and package need confirmation. Listed as unavailable on the page. | https://www.digikey.com/en/products/detail/texas-instruments/LM2940CT-5-0-NOPB/32575
50 | STP80NF55-08 | 0.75 | USD | 63.15 | Catalogue | Tayda Electronics; suffix -08 selected for the estimate. | https://www.taydaelectronics.com/stp80nf55-mosfet-8-mohm-80a-55v-n-channel-to-220-3-stp80nf55-08.html
51 | STP80PF55 | 7.20 | USD | 606.22 | Catalogue | eBay, flex-direct: lot of 2 for $14.40. The estimate includes 1 unit; buying the lot costs more. | https://www.ebay.com/itm/126448719663
52 | Exact part number not selected | 60.00 | RUB | 60.00 | Estimate | DG103-02P terminal-block estimate; pitch and exact variant need confirmation. | Retailer price not confirmed
53 | Exact part number not selected | 40.00 | RUB | 40.00 | Estimate | IDC10 estimate; connector type, pitch and orientation unspecified. | Retailer price not confirmed
54 | Exact part number not selected | 15.00 | RUB | 15.00 | Estimate | KLS7-TS6601-4.3-180 estimate; retailer price not confirmed. | Retailer price not confirmed
55 | Exact part number not selected | 50.00 | RUB | 50.00 | Estimate | Budget allowance for a connector. SWD1 is insufficient to select a product. | Retailer price not confirmed
56 | Exact part number not selected | 70.00 | RUB | 70.00 | Estimate | Estimate for a 220 µF, 50 V radial electrolytic; dimensions and series unspecified. | Retailer price not confirmed
57 | Exact part number not selected | 120.00 | RUB | 120.00 | Estimate | Estimate for a 680 µF, 50 V radial electrolytic; dimensions and series unspecified. | Retailer price not confirmed
58 | Exact part number not selected | 160.00 | RUB | 160.00 | Estimate | Estimate for a 1000 µF, 50 V radial electrolytic; dimensions and series unspecified. | Retailer price not confirmed
59 | TEN 5-2422 | 32.64 | USD | 2748.21 | Catalogue |  | https://www.digikey.com/en/products/detail/traco-power/TEN-5-2422/9383746
