neuroandriyanov/PropValve-RE06MT/схема_плата/Спецификация_для_пайк.xlsx

Sheet: Порядок пайки
№ пакета | Метки | Значение | Тип | Кол-во | Цена/шт, ₽ | Стоимость, ₽ | Спаяно
1. Резисторы и конденсаторы 0805
1 | C54 | 3.3nF 25V | CAP_0805 | 1 | 15.00 | 15.00
2 | C50 | 56nF 25V | CAP_0805 | 1 | 15.00 | 15.00
3 | C34, C35, C36, C38, C40, C43, C53, C57, C62, C63, C65, C66, C69, C70, C94, C97 | 0.1uF 25V | CAP_0805 | 16 | 9.26 | 148.16
4 | C39, C44, C46, C58, C64 | 10uF 25V | CAP_0805 | 5 | 17.68 | 88.40
5 | R57 | 51 | RES_0805 | 1 | 8.42 | 8.42
6 | R48 | 475 | RES_0805 | 1 | 8.42 | 8.42
7 | R44 | 1K | RES_0805 | 1 | 8.42 | 8.42
8 | R68, R69, R71, R72 | 2.2K | RES_0805 | 4 | 8.42 | 33.68
9 | R46, R47, R49, R51, R53, R54, R59 | 10K | RES_0805 | 7 | 8.42 | 58.94
10 | R45 | 18K | RES_0805 | 1 | 8.42 | 8.42
11 | R60 | 100K | RES_0805 | 1 | 8.42 | 8.42
2. Мелкие диоды и транзисторы
12 | D13, D14 | BAS70W-04 | BAS70W-04 | 2 | 29.47 | 58.94
13 | D10, D11, D16, D17 |  | BAV99 | 4 | 17.68 | 70.72
14 | VT1 | FMMT717TA | FMMT717TA | 1 | 69.04 | 69.04
3. Резисторы и конденсаторы 1206
15 | C13, C17 | 0.01uF 25v | CAP_1206 | 2 | 15.00 | 30.00
16 | C16 | 0.03uF 25v | CAP_1206 | 1 | 20.00 | 20.00
17 | C9, C12, C14, C15, C18, C19, C20, C21, C22, C23, C25 | 0.1uF 25v | CAP_1206 | 11 | 15.00 | 165.00
18 | C52 | 47uF 25V | CAP_1206 | 1 | 82.51 | 82.51
19 | R4 | 10 | RES1206 | 1 | 8.42 | 8.42
20 | R3, R42, R43 | 180 | RES1206 | 3 | 8.42 | 25.26
21 | R6, R9, R10, R15, R16, R17, R18, R19, R20, R21, R22, R30, R32, R34, R35 | 1K | RES1206 | 15 | 8.42 | 126.30
22 | R24, R25 | 2K | RES1206 | 2 | 8.42 | 16.84
23 | R8, R11, R26, R28, R38, R39, R40, R41 | 10K | RES1206 | 8 | 8.42 | 67.36
24 | R36 | 14K | RES1206 | 1 | 8.42 | 8.42
25 | R13, R27, R29 | 20K | RES1206 | 3 | 8.42 | 25.26
26 | R31, R33 | 25K | RES1206 | 2 | 8.42 | 16.84
27 | R1, R2, R23 | 30K | RES1206 | 3 | 8.42 | 25.26
28 | R7, R12 | 51K | RES1206 | 2 | 8.42 | 16.84
29 | R14, R37 | 100K | RES1206 | 2 | 8.42 | 16.84
4. Конденсаторы 1210
30 | C4, C6, C8, C11, C24 | 10uF 50v | CAP1210 | 5 | 58.10 | 290.50
5. Микросхемы и генератор
31 | DD4 | 24LC512 | 24LC512 | 1 | 154.08 | 154.08
32 | DD3 | 74LVC1G125GV | 74LVC1G125GV | 1 | 30.00 | 30.00
33 | DA1 | ACS712 | ACS712 | 1 | 336.79 | 336.79
34 | DD1 | ADAU1701JSTZ | ADAU1701JSTZ | 1 | 1243.60 | 1243.60
35 | DD5 | ADM811R | ADM811R | 1 | 178.50 | 178.50
36 | OSC1 | ASFL1-12.288MHZ | ASFL1-12.288MHZ | 1 | 184.39 | 184.39
37 | DD2 | ISO1540DR | ISO1540DR | 1 | 394.04 | 394.04
38 | DA9 | LDL1117S33R | LDL1117S33R | 1 | 34.52 | 34.52
39 | DA4, DA5, DA6, DA7, DA8 |  | OP2177 | 5 | 556.55 | 2782.75
40 | DA3 |  | TL494 | 1 | 37.89 | 37.89
6. Защитные и выводные диоды
41 | D1 | 1.5KE30A | 1.5KE30A | 1 | 77.46 | 77.46
42 | D4, D5, D8 | 1N4744A | 1N4744A | 3 | 23.58 | 70.74
43 | D2, D3 | SMBJ12A | SMBJ12A | 2 | 41.26 | 82.52
44 | D12 | SMBJ3V3 | SMBJ3V3 | 1 | 63.15 | 63.15
45 | D9, D15 | SMBJ5A / SMBJ5.0 | SMBJ5A / SMBJ5.0 | 2 | 42.10 | 84.20
46 | D6, D7 | SR540 | SR540 | 2 | 35.00 | 70.00
7. Силовые элементы и оптодрайвер
47 | R5 | 330 2ВТ | 330 2ВТ | 1 | 25.00 | 25.00
48 | OPT1 | HCPL3120 | HCPL3120 | 1 | 323.32 | 323.32
49 | DA2 | LM2940 | LM2940 | 1 | 168.40 | 168.40
50 | Q2 | STP80NF55 | STP80NF55 | 1 | 63.15 | 63.15
51 | Q1 | STP80PF55 | STP80PF55 | 1 | 606.22 | 606.22
8. Разъёмы и кнопка
52 | X1, X2, X3, X4 |  | DG103-02P | 4 | 60.00 | 240.00
53 | X5 |  | IDC10 | 1 | 40.00 | 40.00
54 | SA1 | KLS7-TS6601-4.3-180 | KLS7-TS6601-4.3-180 | 1 | 15.00 | 15.00
55 | J1, J2 |  | SWD1 | 2 | 50.00 | 100.00
9. Электролиты и модуль питания
56 | C10 | 220uF 50v | K50-35 | 1 | 70.00 | 70.00
57 | C5, C7 | 680uF 50v | K50-35 | 2 | 120.00 | 240.00
58 | C1, C2, C3 | 1000uF 50v | K50-35 | 3 | 160.00 | 480.00
59 | U1 | TEN 5-2422 | TEN 5-2422 | 1 | 2748.21 | 2748.21
 | Итого: элементы и ориентировочная стоимость |  |  | 153 |  | 12485.56

Sheet: Исходные данные
Метка | Значение | Тип
C1 | 1000uF 50v | K50-35
C2 | 1000uF 50v | K50-35
C3 | 1000uF 50v | K50-35
C4 | 10uF 50v | CAP1210
C5 | 680uF 50v | K50-35
C6 | 10uF 50v | CAP1210
C7 | 680uF 50v | K50-35
C8 | 10uF 50v | CAP1210
C9 | 0.1uF 25v | CAP_1206
C10 | 220uF 50v | K50-35
C11 | 10uF 50v | CAP1210
C12 | 0.1uF 25v | CAP_1206
C13 | 0.01uF 25v | CAP_1206
C14 | 0.1uF 25v | CAP_1206
C15 | 0.1uF 25v | CAP_1206
C16 | 0.03uF 25v | CAP_1206
C17 | 0.01uF 25v | CAP_1206
C18 | 0.1uF 25v | CAP_1206
C19 | 0.1uF 25v | CAP_1206
C20 | 0.1uF 25v | CAP_1206
C21 | 0.1uF 25v | CAP_1206
C22 | 0.1uF 25v | CAP_1206
C23 | 0.1uF 25v | CAP_1206
C24 | 10uF 50v | CAP1210
C25 | 0.1uF 25v | CAP_1206
C34 | 0.1uF 25V | CAP_0805
C35 | 0.1uF 25V | CAP_0805
C36 | 0.1uF 25V | CAP_0805
C38 | 0.1uF 25V | CAP_0805
C39 | 10uF 25V | CAP_0805
C40 | 0.1uF 25V | CAP_0805
C43 | 0.1uF 25V | CAP_0805
C44 | 10uF 25V | CAP_0805
C46 | 10uF 25V | CAP_0805
C50 | 56nF 25V | CAP_0805
C52 | 47uF 25V | CAP_1206
C53 | 0.1uF 25V | CAP_0805
C54 | 3.3nF 25V | CAP_0805
C57 | 0.1uF 25V | CAP_0805
C58 | 10uF 25V | CAP_0805
C62 | 0.1uF 25V | CAP_0805
C63 | 0.1uF 25V | CAP_0805
C64 | 10uF 25V | CAP_0805
C65 | 0.1uF 25V | CAP_0805
C66 | 0.1uF 25V | CAP_0805
C69 | 0.1uF 25V | CAP_0805
C70 | 0.1uF 25V | CAP_0805
C94 | 0.1uF 25V | CAP_0805
C97 | 0.1uF 25V | CAP_0805
D1 | 1.5KE30A | 1.5KE30A
D2 | SMBJ12A | SMBJ12A
D3 | SMBJ12A | SMBJ12A
D4 | 1N4744A | 1N4744A
D5 | 1N4744A | 1N4744A
D6 | SR540 | SR540
D7 | SR540 | SR540
D8 | 1N4744A | 1N4744A
D9 | SMBJ5A | SMBJ5A
D10 |  | BAV99
D11 |  | BAV99
D12 | SMBJ3V3 | SMBJ3V3
D13 | BAS70W-04 | BAS70W-04
D14 | BAS70W-04 | BAS70W-04
D15 | SMBJ5.0 | SMBJ5.0
D16 |  | BAV99
D17 |  | BAV99
DA1 | ACS712 | ACS712
DA2 | LM2940 | LM2940
DA3 |  | TL494
DA4 |  | OP2177
DA5 |  | OP2177
DA6 |  | OP2177
DA7 |  | OP2177
DA8 |  | OP2177
DA9 | LDL1117S33R | LDL1117S33R
DD1 | ADAU1701JSTZ | ADAU1701JSTZ
DD2 | ISO1540DR | ISO1540DR
DD3 | 74LVC1G125GV | 74LVC1G125GV
DD4 | 24LC512 | 24LC512
DD5 | ADM811R | ADM811R
J1 |  | SWD1
J2 |  | SWD1
OPT1 | HCPL3120 | HCPL3120
OSC1 | ASFL1-12.288MHZ | ASFL1-12.288MHZ
Q1 | STP80PF55 | STP80PF55
Q2 | STP80NF55 | STP80NF55
R1 | 30K | RES1206
R2 | 30K | RES1206
R3 | 180 | RES1206
R4 | 10 | RES1206
R5 | 330 2ВТ | 330 2ВТ
R6 | 1K | RES1206
R7 | 51K | RES1206
R8 | 10K | RES1206
R9 | 1K | RES1206
R10 | 1K | RES1206
R11 | 10K | RES1206
R12 | 51K | RES1206
R13 | 20K | RES1206
R14 | 100K | RES1206
R15 | 1K | RES1206
R16 | 1K | RES1206
R17 | 1K | RES1206
R18 | 1K | RES1206
R19 | 1K | RES1206
R20 | 1K | RES1206
R21 | 1K | RES1206
R22 | 1K | RES1206
R23 | 30K | RES1206
R24 | 2K | RES1206
R25 | 2K | RES1206
R26 | 10K | RES1206
R27 | 20K | RES1206
R28 | 10K | RES1206
R29 | 20K | RES1206
R30 | 1K | RES1206
R31 | 25K | RES1206
R32 | 1K | RES1206
R33 | 25K | RES1206
R34 | 1K | RES1206
R35 | 1K | RES1206
R36 | 14K | RES1206
R37 | 100K | RES1206
R38 | 10K | RES1206
R39 | 10K | RES1206
R40 | 10K | RES1206
R41 | 10K | RES1206
R42 | 180 | RES1206
R43 | 180 | RES1206
R44 | 1K | RES_0805
R45 | 18K | RES_0805
R46 | 10K | RES_0805
R47 | 10K | RES_0805
R48 | 475 | RES_0805
R49 | 10K | RES_0805
R51 | 10K | RES_0805
R53 | 10K | RES_0805
R54 | 10K | RES_0805
R57 | 51 | RES_0805
R59 | 10K | RES_0805
R60 | 100K | RES_0805
R68 | 2.2K | RES_0805
R69 | 2.2K | RES_0805
R71 | 2.2K | RES_0805
R72 | 2.2K | RES_0805
SA1 | KLS7-TS6601-4.3-180 | KLS7-TS6601-4.3-180
U1 | TEN 5-2422 | TEN 5-2422
VT1 | FMMT717TA | FMMT717TA
X1 |  | DG103-02P
X2 |  | DG103-02P
X3 |  | DG103-02P
X4 |  | DG103-02P
X5 |  | IDC10

Sheet: Цены и источники
Ориентировочные цены комплектующих
Проверено 20.09.2026. Цены за 1 шт.; без доставки, налогов, пошлин и наценок посредников.
USD → RUB | 84.1975 | Курс ЦБ с 19.09.2026: https://www.cbr.ru/currency_base/daily/
«Каталог» — найденная цена выбранного исполнения. «Оценка» — предположение; «Оценка по серии» — цена похожего номинала.
Подбор исполнения служит только для оценки стоимости; метки, номиналы и типы в спецификации не заменены.
№ пакета | Товар для оценки | Цена источника | Валюта | Цена/шт, ₽ | Основание | Пояснение | Источник
1 | Точный артикул не подобран | 15.00 | RUB | 15.00 | Оценка | Оценка для 3,3 нФ / 25 В / 0805; диэлектрик и допуск не заданы. | Цена магазина не подтверждена
2 | Точный артикул не подобран | 15.00 | RUB | 15.00 | Оценка | Оценка для 56 нФ / 25 В / 0805; диэлектрик и допуск не заданы. | Цена магазина не подтверждена
3 | CL21B104KACNNNC | 0.11 | USD | 9.26 | Каталог | 100 нФ, 25 В, 0805, X7R, ±10%; пример исполнения для оценки. | https://www.digikey.com/en/products/detail/samsung-electro-mechanics/CL21B104KACNNNC/3886757
4 | CL21A106KAYNNNE | 0.21 | USD | 17.68 | Каталог | 10 мкФ, 25 В, 0805, X5R; пример исполнения. Нет в наличии на странице. | https://www.digikey.com/en/products/detail/samsung-electro-mechanics/CL21A106KAYNNNE/3888549
5 | RC0805FR-071KL (1 кОм) | 0.10 | USD | 8.42 | Оценка по серии | Ориентир по резистору 1 кОм серии 0805; цена именно номинала 51 не подтверждена. | https://www.digikey.com/en/products/detail/yageo/RC0805FR-071KL/727444
6 | RC0805FR-071KL (1 кОм) | 0.10 | USD | 8.42 | Оценка по серии | Ориентир по резистору 1 кОм серии 0805; цена именно номинала 475 не подтверждена. | https://www.digikey.com/en/products/detail/yageo/RC0805FR-071KL/727444
7 | RC0805FR-071KL (1 кОм) | 0.10 | USD | 8.42 | Каталог | Цена за 1 шт.; скидки за количество не применены. | https://www.digikey.com/en/products/detail/yageo/RC0805FR-071KL/727444
8 | RC0805FR-071KL (1 кОм) | 0.10 | USD | 8.42 | Оценка по серии | Ориентир по резистору 1 кОм серии 0805; цена именно номинала 2.2K не подтверждена. | https://www.digikey.com/en/products/detail/yageo/RC0805FR-071KL/727444
9 | RC0805FR-071KL (1 кОм) | 0.10 | USD | 8.42 | Оценка по серии | Ориентир по резистору 1 кОм серии 0805; цена именно номинала 10K не подтверждена. | https://www.digikey.com/en/products/detail/yageo/RC0805FR-071KL/727444
10 | RC0805FR-071KL (1 кОм) | 0.10 | USD | 8.42 | Оценка по серии | Ориентир по резистору 1 кОм серии 0805; цена именно номинала 18K не подтверждена. | https://www.digikey.com/en/products/detail/yageo/RC0805FR-071KL/727444
11 | RC0805FR-071KL (1 кОм) | 0.10 | USD | 8.42 | Оценка по серии | Ориентир по резистору 1 кОм серии 0805; цена именно номинала 100K не подтверждена. | https://www.digikey.com/en/products/detail/yageo/RC0805FR-071KL/727444
12 | BAS70W-04-7-F | 0.35 | USD | 29.47 | Каталог | Нет в наличии на странице; цена под заказ. | https://www.digikey.com/en/products/detail/diodes-incorporated/BAS70W-04-7-F/815026
13 | BAV99, SMC Diode Solutions | 0.21 | USD | 17.68 | Каталог | Производитель в исходнике не задан; пример цены BAV99. | https://www.digikey.com/en/products/detail/smc-diode-solutions/BAV99/6022507
14 | FMMT717TA | 0.82 | USD | 69.04 | Каталог |  | https://www.digikey.com/en/products/detail/diodes-incorporated/FMMT717TA/243276
15 | Точный артикул не подобран | 15.00 | RUB | 15.00 | Оценка | Оценка для 0,01 мкФ / 25 В / 1206; диэлектрик и допуск не заданы. | Цена магазина не подтверждена
16 | Точный артикул не подобран | 20.00 | RUB | 20.00 | Оценка | Оценка для 0,03 мкФ / 25 В / 1206. Номинал 0,03 сохранён; не заменён на 0,033. | Цена магазина не подтверждена
17 | Точный артикул не подобран | 15.00 | RUB | 15.00 | Оценка | Оценка для 0,1 мкФ / 25 В / 1206; диэлектрик и допуск не заданы. | Цена магазина не подтверждена
18 | C3216X5R1E476M160AC | 0.98 | USD | 82.51 | Каталог | 47 мкФ, 25 В, 1206, X5R; пример исполнения. Нет в наличии на странице. | https://www.digikey.com/en/products/detail/tdk/C3216X5R1E476M160AC/2792260
19 | RC1206FR-071KL (1 кОм) | 0.10 | USD | 8.42 | Оценка по серии | Ориентир по резистору 1 кОм серии 1206; цена именно номинала 10 не подтверждена. | https://www.digikey.com/en/products/detail/yageo/RC1206FR-071KL/728387
20 | RC1206FR-071KL (1 кОм) | 0.10 | USD | 8.42 | Оценка по серии | Ориентир по резистору 1 кОм серии 1206; цена именно номинала 180 не подтверждена. | https://www.digikey.com/en/products/detail/yageo/RC1206FR-071KL/728387
21 | RC1206FR-071KL (1 кОм) | 0.10 | USD | 8.42 | Каталог | Цена за 1 шт.; скидки за количество не применены. | https://www.digikey.com/en/products/detail/yageo/RC1206FR-071KL/728387
22 | RC1206FR-071KL (1 кОм) | 0.10 | USD | 8.42 | Оценка по серии | Ориентир по резистору 1 кОм серии 1206; цена именно номинала 2K не подтверждена. | https://www.digikey.com/en/products/detail/yageo/RC1206FR-071KL/728387
23 | RC1206FR-071KL (1 кОм) | 0.10 | USD | 8.42 | Оценка по серии | Ориентир по резистору 1 кОм серии 1206; цена именно номинала 10K не подтверждена. | https://www.digikey.com/en/products/detail/yageo/RC1206FR-071KL/728387
24 | RC1206FR-071KL (1 кОм) | 0.10 | USD | 8.42 | Оценка по серии | Ориентир по резистору 1 кОм серии 1206; цена именно номинала 14K не подтверждена. | https://www.digikey.com/en/products/detail/yageo/RC1206FR-071KL/728387
25 | RC1206FR-071KL (1 кОм) | 0.10 | USD | 8.42 | Оценка по серии | Ориентир по резистору 1 кОм серии 1206; цена именно номинала 20K не подтверждена. | https://www.digikey.com/en/products/detail/yageo/RC1206FR-071KL/728387
26 | RC1206FR-071KL (1 кОм) | 0.10 | USD | 8.42 | Оценка по серии | Ориентир по резистору 1 кОм серии 1206; цена именно номинала 25K не подтверждена. | https://www.digikey.com/en/products/detail/yageo/RC1206FR-071KL/728387
27 | RC1206FR-071KL (1 кОм) | 0.10 | USD | 8.42 | Оценка по серии | Ориентир по резистору 1 кОм серии 1206; цена именно номинала 30K не подтверждена. | https://www.digikey.com/en/products/detail/yageo/RC1206FR-071KL/728387
28 | RC1206FR-071KL (1 кОм) | 0.10 | USD | 8.42 | Оценка по серии | Ориентир по резистору 1 кОм серии 1206; цена именно номинала 51K не подтверждена. | https://www.digikey.com/en/products/detail/yageo/RC1206FR-071KL/728387
29 | RC1206FR-071KL (1 кОм) | 0.10 | USD | 8.42 | Оценка по серии | Ориентир по резистору 1 кОм серии 1206; цена именно номинала 100K не подтверждена. | https://www.digikey.com/en/products/detail/yageo/RC1206FR-071KL/728387
30 | CL32B106KBJNNNE | 0.69 | USD | 58.10 | Каталог | 10 мкФ, 50 В, 1210, X7R; пример исполнения. Нет в наличии на странице. | https://www.digikey.com/en/products/detail/samsung-electro-mechanics/CL32B106KBJNNNE/3889045
31 | 24LC512-I/ST | 1.83 | USD | 154.08 | Каталог | Для оценки взят TSSOP-8; корпус 24LC512 в исходнике не указан. | https://www.digikey.com/en/products/detail/microchip-technology/24LC512-I-ST/2201938
32 | Точный артикул не подобран | 30.00 | RUB | 30.00 | Оценка | Оценка цены 74LVC1G125GV; предложение с подтверждённой ценой не найдено. | Цена магазина не подтверждена
33 | ACS712ELCTR-05B-T | 4.00 | USD | 336.79 | Каталог | Для оценки взято исполнение 5 А; в спецификации указан только ACS712. | https://www.digikey.com/en/products/detail/allegro-microsystems/ACS712ELCTR-05B-T/1284593
34 | ADAU1701JSTZ | 14.77 | USD | 1243.60 | Каталог |  | https://www.digikey.com/en/products/detail/analog-devices-inc/ADAU1701JSTZ/1246074
35 | ADM811RARTZ-REEL7 | 2.12 | USD | 178.50 | Каталог | Для оценки взято исполнение SOT-143-4. | https://www.digikey.com/en/products/detail/analog-devices-inc/ADM811RARTZ-REEL7/1007315
36 | ASFL1-12.288MHZ-EC-T | 2.19 | USD | 184.39 | Каталог | Для оценки взят суффикс EC-T; полный суффикс в исходнике отсутствует. | https://www.digikey.com/en/products/detail/abracon-llc/ASFL1-12-288MHZ-EC-T/687856
37 | ISO1540DR | 4.68 | USD | 394.04 | Каталог | Нет в наличии на странице; цена под заказ. | https://www.digikey.com/en/products/detail/texas-instruments/ISO1540DR/3587222
38 | LDL1117S33R | 0.41 | USD | 34.52 | Каталог |  | https://www.digikey.com/en/products/detail/stmicroelectronics/LDL1117S33R/7102071
39 | OP2177ARZ | 6.61 | USD | 556.55 | Каталог | Для оценки взят SOIC-8; полный суффикс отсутствует. Нет в наличии на странице. | https://www.digikey.com/en/products/detail/analog-devices-inc/OP2177ARZ/820332
40 | TL494CDR | 0.45 | USD | 37.89 | Каталог | Для оценки взят SOIC-16; корпус в исходнике не указан. | https://www.digikey.com/en/products/detail/texas-instruments/TL494CDR/276936
41 | 1.5KE30A, Littelfuse | 0.92 | USD | 77.46 | Каталог |  | https://www.digikey.com/en/products/detail/littelfuse-inc/1-5KE30A/285858
42 | 1N4744A, onsemi | 0.28 | USD | 23.58 | Каталог |  | https://www.digikey.com/en/products/detail/onsemi/1N4744A/977267
43 | SMBJ12A, Littelfuse | 0.49 | USD | 41.26 | Каталог |  | https://www.digikey.com/en/products/detail/littelfuse-inc/SMBJ12A/285970
44 | SMBJ3V3-E3/5B | 0.75 | USD | 63.15 | Каталог |  | https://www.digikey.com/en/products/detail/vishay-general-semiconductor-diodes-division/SMBJ3V3-E3-5B/2147834
45 | SMBJ5.0A, Littelfuse | 0.50 | USD | 42.10 | Каталог | Цена для объединённых по указанию пользователя D9 и D15. | https://www.digikey.com/en/products/detail/littelfuse-inc/SMBJ5-0A/285950
46 | Точный артикул не подобран | 35.00 | RUB | 35.00 | Оценка | Оценка SR540; цена точного артикула в магазине не подтверждена. | Цена магазина не подтверждена
47 | Точный артикул не подобран | 25.00 | RUB | 25.00 | Оценка | Оценка резистора 330 Ом, 2 Вт; материал и допуск не заданы. | Цена магазина не подтверждена
48 | HCPL-3120-000E | 3.84 | USD | 323.32 | Каталог | Для оценки взят DIP-8; суффикс в исходнике не указан. | https://www.digikey.com/en/products/detail/broadcom-limited/HCPL-3120-000E/669903
49 | LM2940CT-5.0/NOPB | 2.00 | USD | 168.40 | Каталог | Для оценки взято 5 В, TO-220; напряжение и корпус уточнить. Нет в наличии на странице. | https://www.digikey.com/en/products/detail/texas-instruments/LM2940CT-5-0-NOPB/32575
50 | STP80NF55-08 | 0.75 | USD | 63.15 | Каталог | Tayda Electronics; суффикс -08 взят для оценки. | https://www.taydaelectronics.com/stp80nf55-mosfet-8-mohm-80a-55v-n-channel-to-220-3-stp80nf55-08.html
51 | STP80PF55 | 7.20 | USD | 606.22 | Каталог | eBay, flex-direct: лот 2 шт. за $14,40. В смете учтена 1 шт.; покупка лота дороже. | https://www.ebay.com/itm/126448719663
52 | Точный артикул не подобран | 60.00 | RUB | 60.00 | Оценка | Оценка клеммника DG103-02P; шаг и точное исполнение уточнить. | Цена магазина не подтверждена
53 | Точный артикул не подобран | 40.00 | RUB | 40.00 | Оценка | Оценка IDC10; тип, шаг и ориентация разъёма не заданы. | Цена магазина не подтверждена
54 | Точный артикул не подобран | 15.00 | RUB | 15.00 | Оценка | Оценка KLS7-TS6601-4.3-180; цена магазина не подтверждена. | Цена магазина не подтверждена
55 | Точный артикул не подобран | 50.00 | RUB | 50.00 | Оценка | Бюджетный резерв на разъём. SWD1 — недостаточное обозначение для подбора товара. | Цена магазина не подтверждена
56 | Точный артикул не подобран | 70.00 | RUB | 70.00 | Оценка | Оценка 220 мкФ, 50 В, радиальный электролит; размеры и серия не заданы. | Цена магазина не подтверждена
57 | Точный артикул не подобран | 120.00 | RUB | 120.00 | Оценка | Оценка 680 мкФ, 50 В, радиальный электролит; размеры и серия не заданы. | Цена магазина не подтверждена
58 | Точный артикул не подобран | 160.00 | RUB | 160.00 | Оценка | Оценка 1000 мкФ, 50 В, радиальный электролит; размеры и серия не заданы. | Цена магазина не подтверждена
59 | TEN 5-2422 | 32.64 | USD | 2748.21 | Каталог |  | https://www.digikey.com/en/products/detail/traco-power/TEN-5-2422/9383746
