neuroandriyanov/PropValve-RE06MT/docs/INVENTORY.md

# Обзор исходной папки и состав пакета

[Русский](INVENTORY.md) | [English](INVENTORY.en.md)

Все исходные каталоги учтены. Содержимое документации и журналов прочитано, PDF-схема просмотрена на обоих листах, паспорт клапана извлечён и сверены страницы электрических данных/подключения, фотографии просмотрены. Все десять `.dspproj` разобраны как данные, рассмотрены таблицы, константы и сохранённый netlist рабочей версии. Исходники инструментов проверены на зависимости, пути и операции управления. Из XLSX прочитаны данные спецификации; файл не редактировался.

В текущем пакете оставлены PDF-схема, Gerber/сверловка и спецификация; исходники DipTrace и библиотеки исключены автором. Модели заглушки сохранены без редактирования и без полной проверки в 3D-редакторе. Геометрическая сверка Gerber с CAD не выполнялась. Ассистент не запускал оборудование при обзоре файлов; автор отдельно подтвердил успешные испытания и работу платы на машине без наблюдаемого нагрева.

| Исходный каталог | Содержимое и решение |
| --- | --- |
| `фото/` | Четыре JPG скопированы полностью и без изменения байтов: обе стороны платы, корпус на машине и плата в корпусе |
| `doc/` | Скопирован шестистраничный PDF Parker RE06M*T |
| `схема_плата/` | Сохранены PDF, XLSX и 9 файлов Gerber/сверловки. DipTrace, библиотеки и ZIP-дубликат удалены автором из пакета |
| `проект_сигма/` | Сохранены десять проектов, TXT/JSON и результаты компиляции. Два образа EEPROM вынесены в архив |
| `корпус/` | Сохранены `.m3d`, `.stl`, `.lxcf`; добавлены изображение `RUICHI A09.jpg` и README |
| `tools/` | Исходные скрипты сохранены в `archive/legacy-tools/`. Для начала работы подготовлен небольшой отдельный набор в `tools/` |
| `output/meter/` | JSON/JSONL протоколы перенесены в `measurements/2026-10-27/`; `latest.json`, снимки окон и их метаданные исключены |
| `tmp/` | Временные снимки, вырезки, аргументы API и результаты диагностики в пакет не включены |
| `программа_мультиметра/` | Сторонняя программа, DLL, установщик runtime и руководства её GUI в пакет не включены; собственный HID-опрос от них не зависит |
| Корневой файл переноса | Оригинал сохранён в `archive/`, новые инструкции находятся в README/AGENTS/docs |

## Повторный обзор 31.10.2026, версия пакета 2

После первоначальной подготовки автор уточнил, что плата уже работает на машине, прошла испытания и не нагревается. Этот статус внесён в README, AGENTS и документацию; прежний пункт об ожидающем испытании объединённой цепи снят. Старые протоколы оставлены неизменными как история калибровки.

Перед обновлением выполнено сравнение с предыдущим манифестом: автор удалил **54 файла**, все из `схема_плата/`: 7 `.dip`, 1 `.dch`, 23 `.eli`, 22 `.lib` и 1 `.zip`. Остальные файлы на момент сравнения не изменились. Удаления сохранены; исходники из соседней рабочей папки не восстанавливались.

Изображение `корпус/RUICHI A09.jpg` найдено в исходной папке, просмотрено и скопировано в пакет без изменения байтов. Оно включено в README. Спецификация XLSX фактически осталась в папке схемы и сохранена.

## Фотографии установки 02.11.2026, версия пакета 4

Из исходной папки `фото/` добавлены два просмотренных снимка: `Корпус.jpg` → `фото/Корпус_на_машине.jpg` и `плата_в_корасе.jpg` → `фото/Плата_в_корпусе.jpg`. Байты изображений сохранены; имена копий уточнены для удобства. В README добавлены изображения с подписями «Корпус блока управления, установленный на машине» и «Плата управления в корпусе — вид при открытой крышке», а в документации корпуса — ссылки на них.

Перед изменением получены коммиты из GitHub до `b774e7c`: авторские правки README, `LICENSE`, `LICENSES/CERN-OHL-P-2.0.txt` и обновлённый NOTICE сохранены. Манифест версии 3 уже расходился с README и NOTICE после этих правок; версия 4 учитывает их, добавленные лицензии, новые фотографии и сопутствующее обновление документации. Схема, Gerber, проекты DSP, инструменты и калибровки не менялись.

При проверке GitHub 02.11.2026 репозиторий уже имел статус Public. Устаревшее указание текущего статуса Private исправлено; настройки доступа не менялись.

## Новые и адаптированные файлы

- `README.md` описывает назначение, вынос платы из зоны нагрева, применение аудио DSP, сигнальные цепи и состав.
- `AGENTS.md` задаёт порядок знакомства с проектом и продолжения отладки ИИ на другом компьютере.
- `docs/SETUP.md`, `docs/STATUS.md` и пояснения в каталогах разделяют актуальную конфигурацию и историю.
- `tools/check_project.py` проверяет контрольные суммы пакета, разбор проектов, согласованность таблиц/экспортов и базовые константы.
- `tools/sigma/inspect_project.py` выводит структурированный отчёт о сохранённом проекте без доступа к оборудованию.
- `tools/meter/meter.ps1` выбирает Python через переменную окружения или PATH, без профиля автора.
- `tools/sigma/build_bridge.ps1` собирает мост штатного API из C# на компьютере пользователя.
- `SigmaBridge.cs`, `sigma_api.py`, `capture_node.py` используют конфигурируемые пути. Для захвата проверяется число выборок и отказ настройки регистра; проверки не пропадают при запуске Python с `-O`.
- `.gitignore` исключает локальные логи, временные файлы, кэш и собранные EXE/DLL. `.gitattributes` сохраняет байты оригиналов и окончания строк для проверки SHA256 после переноса.

## Контрольные суммы

`docs/manifest.json` содержит относительные пути, размеры и SHA256 всех файлов поставки, кроме самого манифеста. Для файлов, происходящих из исходной папки, дополнительно указаны исходный путь, исходный SHA256 и факт изменения при подготовке. Полные пути профиля автора в манифест не записываются.

Манифест фиксирует текущую версию 4 и не обновляется утилитой проверки. Версия 2 учитывала удаление файлов и добавление изображения корпуса, описанные выше. Версия 3 добавляла ссылку на первоначально приватный репозиторий и обновляла сведения о размещении. Версия 4 учитывает фотографии установки, лицензии и изменения документации, описанные выше. В метаданных сохранены SHA256 предыдущего манифеста и описание обновления. После собственных изменений несовпадение с этой поставкой ожидаемо и требует осмысленного сравнения. Проверка соответствия таблиц не доказывает правильность всех связей или работы аппаратуры.

Место размещения по поручению автора — репозиторий [neuroandriyanov/PropValve-RE06MT](https://github.com/neuroandriyanov/PropValve-RE06MT), первоначально приватный, на 02.11.2026 — публичный. В комплект включено содержимое подготовленной папки; соседние исходные каталоги в загрузку не входят.
