neuroandriyanov/PropValve-RE06MT/корпус/заглушка.stl

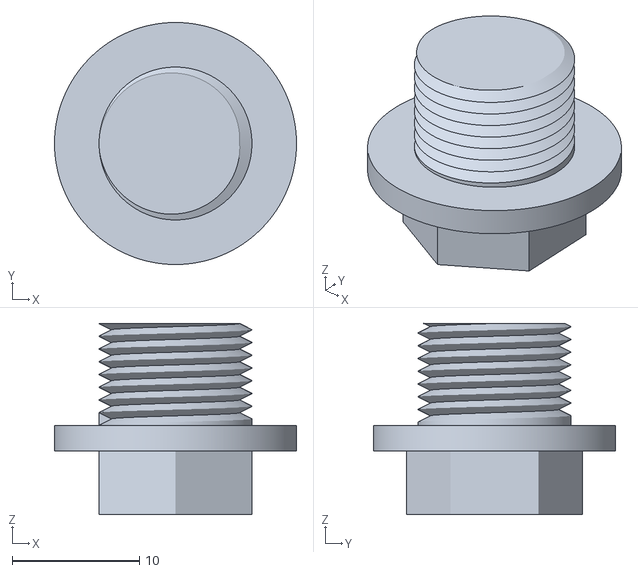
[picture p6: CAD file, 2026-10-31]
корпус/заглушка.stl
19.0 x 19.0 x 15.0
