neuroandriyanov/PropValve-RE06MT/проект_сигма/linintdacout.before_calibration.txt

-0.005513
-0.077409
-0.153823
-0.230275
-0.306728
