neuroandriyanov/PropValve-RE06MT/проект_сигма/linintdacout_calibrated.txt

-0.001020
-0.077378
-0.153747
-0.230275
-0.306728
