neuroandriyanov/PropValve-RE06MT/схема_плата/схема.pdf

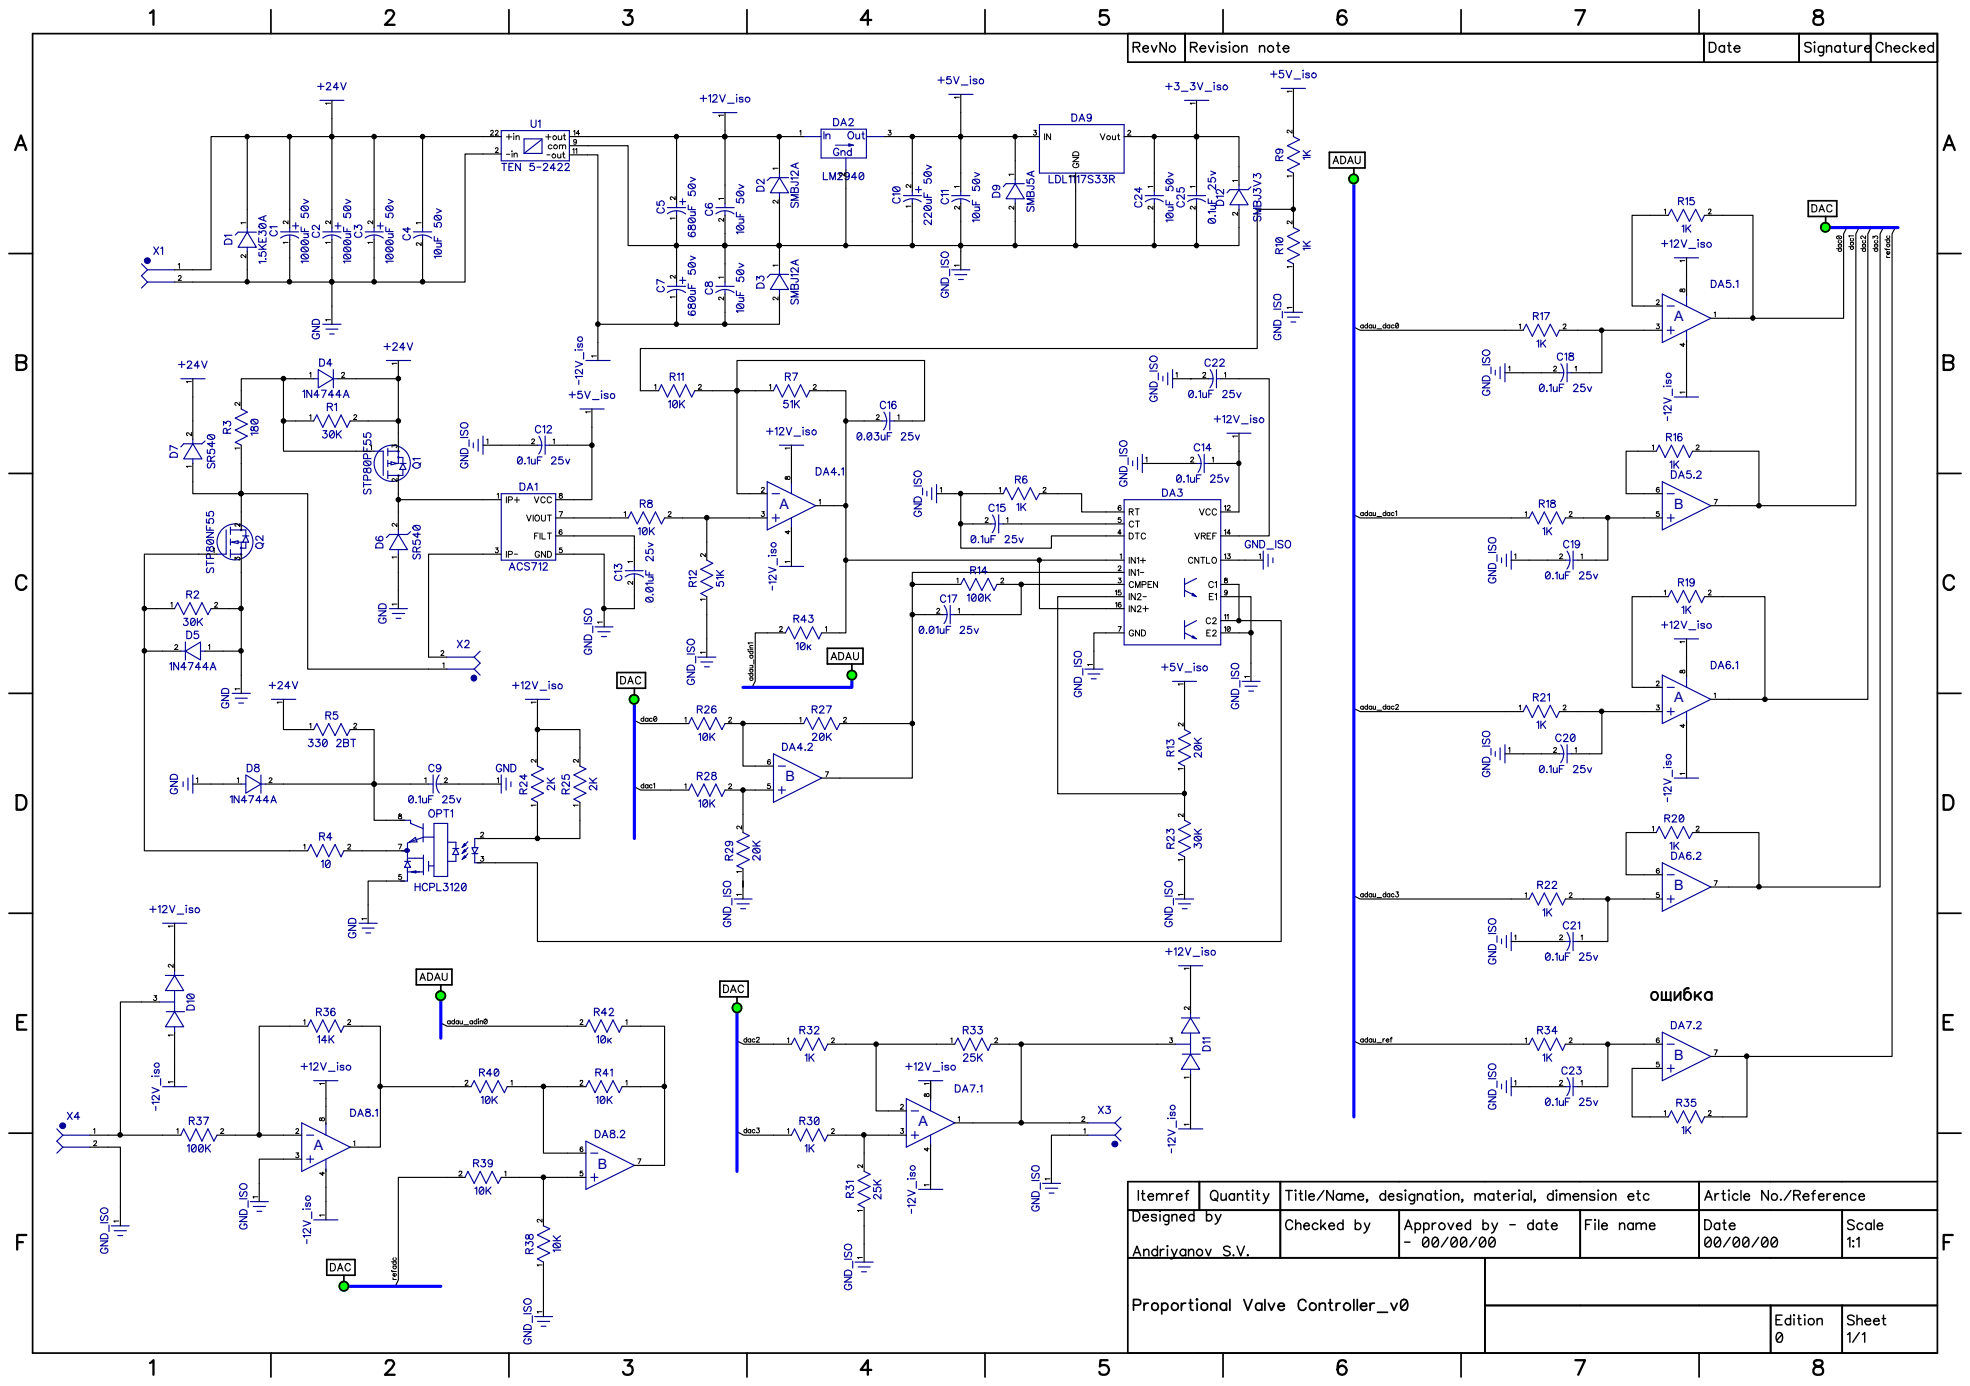
[picture p7: page 1]
ABAB

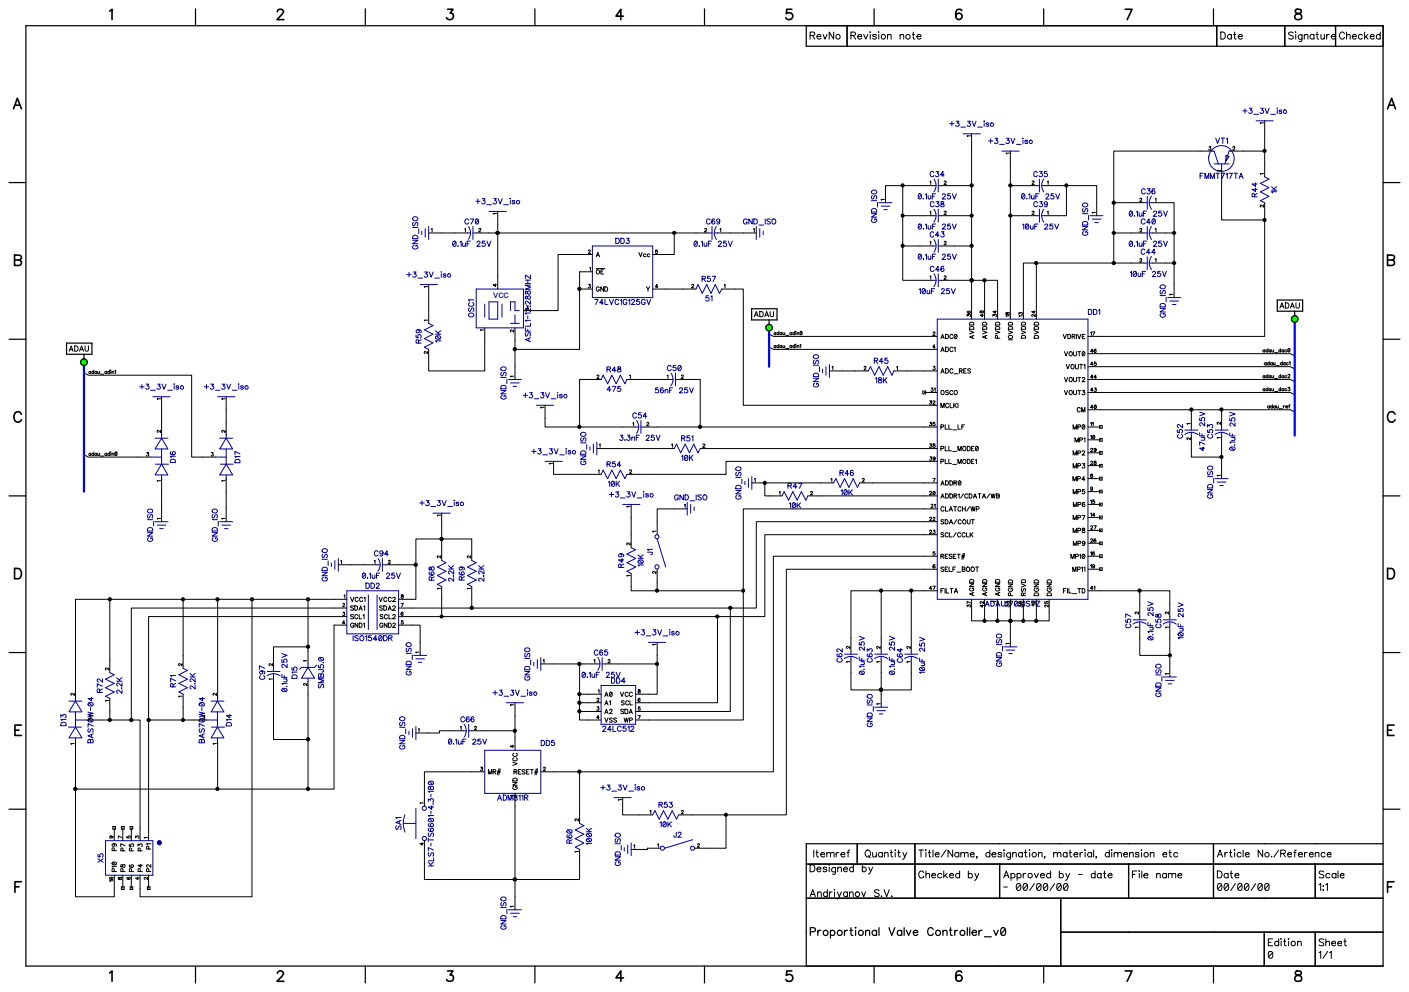
[picture p8: page 2]
vcc
