neuroandriyanov/PropValve-RE06MT/(commit log)

2026-10-31 Add tested RE06MT controller project, hardware files and AI setup
    [Bottom.gbr, Through1.drl, Top.gbr, Верхняямаркировка.gbr, Верхняямаска.gbr, Границыплаты.gbr, Нижняямаска.gbr, Плата.gbr]
2026-10-31 Update README with revised testing information
    Removed redundant information about testing and heating of the board.
2026-11-02 Add installed enclosure and board photos with captions
2026-11-07 Add complete English documentation and BOM with translation tracking
    [Спецификация_для_пайк.en.xlsx]
